Mosiwi/E1K0000_eCar_kit/README.md

# E1K0000_eCar_kit
An ESP32 car, very powerful.
