Mosiwi/E1K0000_eCar_kit/docs/source/Overview/Overview.md

# Overview    
----------
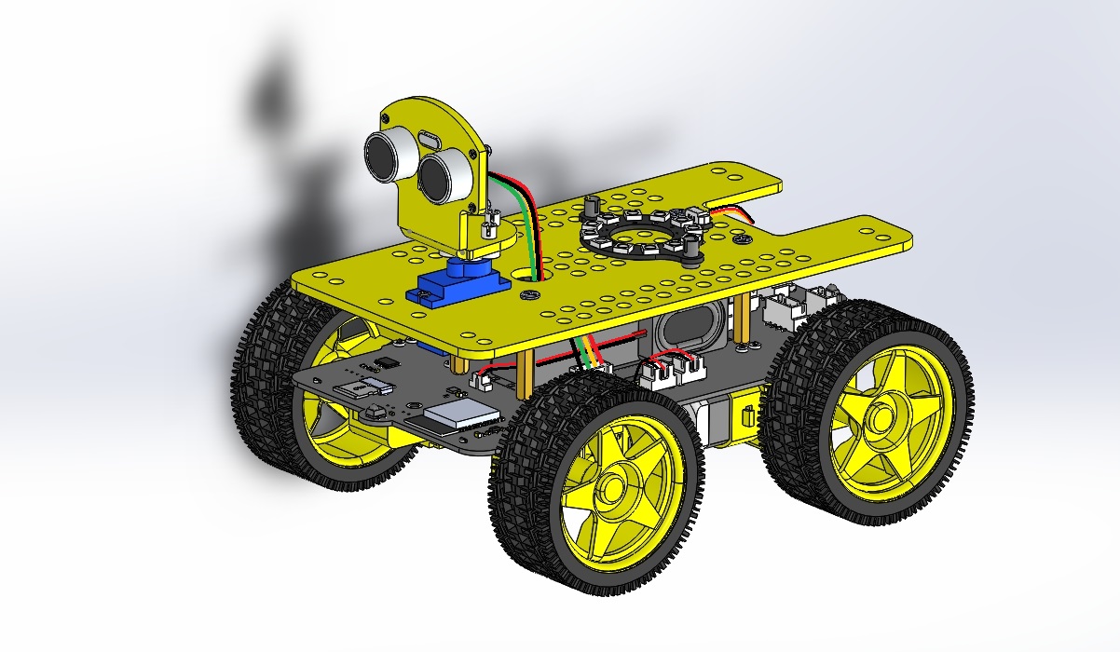
[picture p1: docs/source/_static/overview/img/0img.jpg]
    
This kit provides rich and detailed tutorial materials, very simple installation, many functions, and many interfaces reserved for users to expand by themselves, which is very suitable for DIY or electronics enthusiasts to learn and use.             

**Functional description:**      
• Web_App(Wifi) and infrared remote control.          
• 4 Motor drive (With LED car lights).           
• Speakers, MP3 players play songs (I2S).            
• SD card for storing songs, etc.          
• Touch music alarm.             
• Full color RGB LED.    
• Ultrasonic distance measurement.     
• Servo control ultrasonic module, etc.    
• Compatible with LEGO extensions.     
• IO ports are reserved to expand other functions.           
• With USB port charging function (5V).     
• With power display.         
• Repeatable programming and burning.           

## Functional diagram and specification  
---------------------------------------
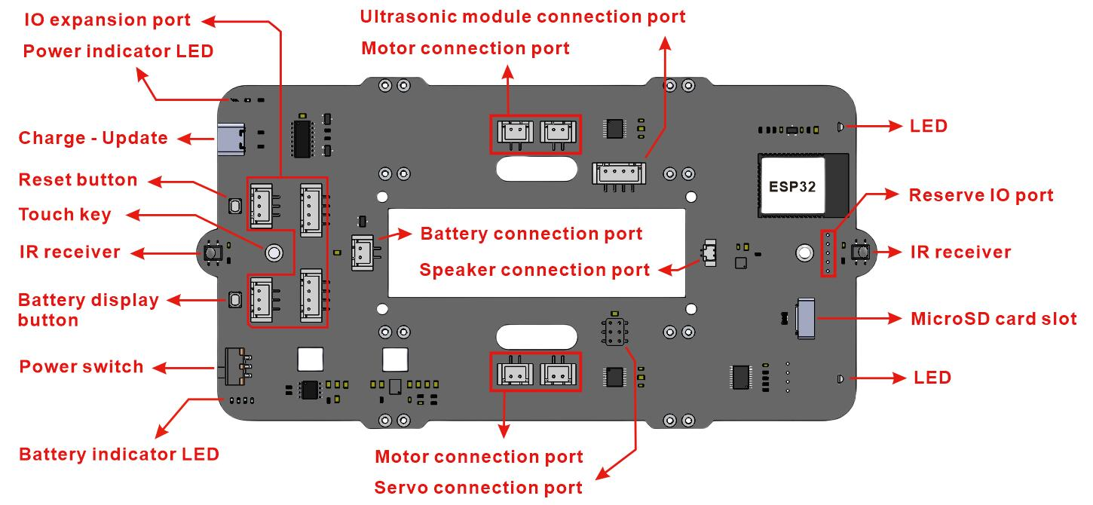
[picture p2: docs/source/_static/overview/img/22img.jpg]
      
    
• Main control chip: ESP32-WROOM-32E      
• System operating voltage: 3.3V        
• Operating voltage of IO port: 3.3V
• Maximum output power: 3.3V/2A   
• Maximum output power: 5V/2A 
• Maximum charge current: 5V/2A   
• Power of speaker: 8Ω/2W      
• Motor speed: 245rpm/6V     

## Recommended battery specification      
------------------------------------
• Model: 18650 lithium battery (Button top)    
• Capacity: >2000mAh    
• Maximum charging voltage: 4.2V    
• Nominal voltage: 3.7V   
• End-off voltage: 2.75V    
• Minimum charging current: >2A     
• Minimum discharge current: >4A   
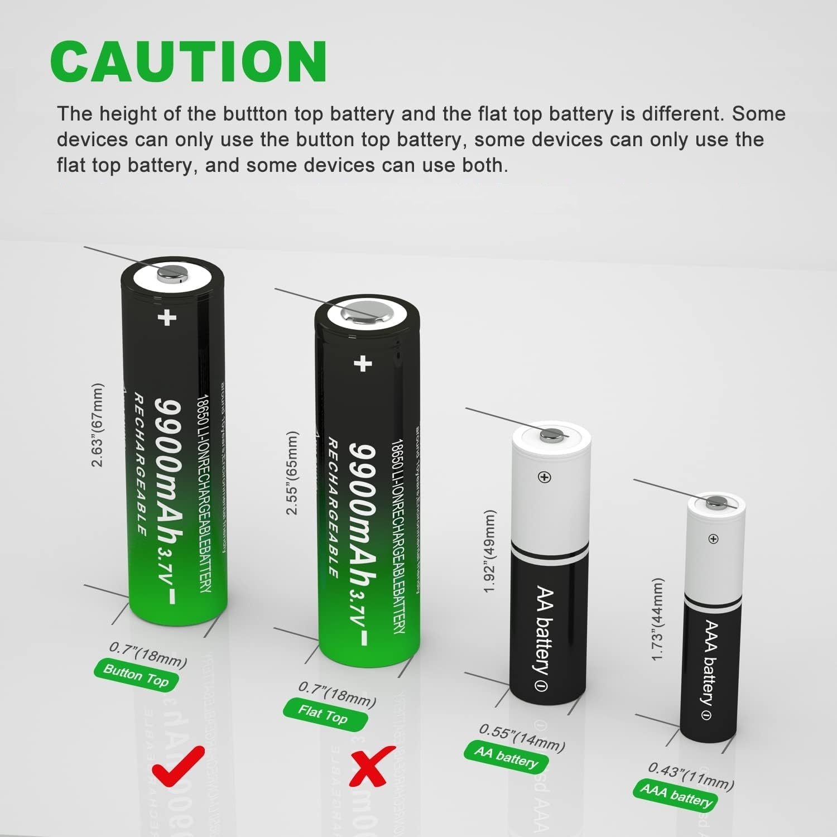
[picture p3: docs/source/_static/overview/img/21img.jpg]
      
     
```{tip}
It's easy to buy on amazon, ebay, or AliExpress.            
```

## Detailed list                
----------------
| eCar drive board | <a href="https://docs.mosiwi.com/en/latest/outsourcing/O1M0000_ultrasonic_module/O1M0000_ultrasonic_module.html" target="_blank">Ultrasonic module</a> | <a href="https://docs.mosiwi.com/en/latest/outsourcing/sg90_servo/sg90_servo.html" target="_blank">Servo</a> | 
| :--: | :--: | :--: |
| 1PCS | 1PCS | 1PCS | 
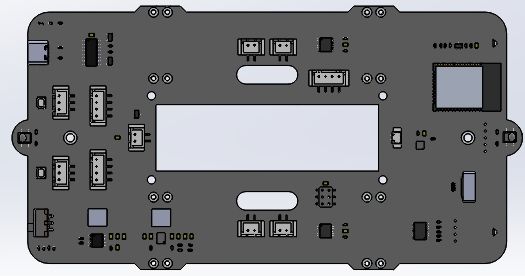
[picture p4: docs/source/_static/overview/img/1img.jpg]
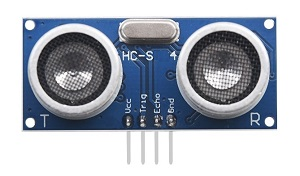
[picture p5: docs/source/_static/overview/img/2img.jpg]
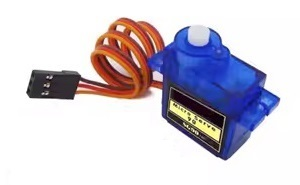
[picture p6: docs/source/_static/overview/img/3img.jpg]
|  |  |  |  
| <a href="https://docs.mosiwi.com/en/latest/outsourcing/nec_ir_remote_control/nec_ir_remote_control.html" target="_blank">IR remote control</a> | RGB LED | Speaker | 
| 1PCS | 1PCS | 1PCS | 
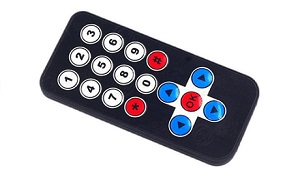
[picture p7: docs/source/_static/overview/img/4img.jpg]
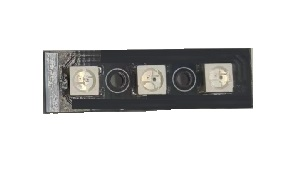
[picture p8: docs/source/_static/overview/img/5img.jpg]
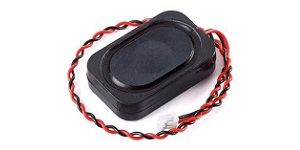
[picture p9: docs/source/_static/overview/img/6img.jpg]
|  |  |  | 
| Acrylic board | Ultrasonic module fixing parts | TT Motor | 
| 1PCS | 1PCS | 4PCS | 
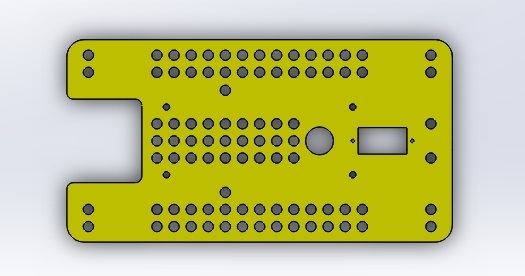
[picture p10: docs/source/_static/overview/img/7img.jpg]
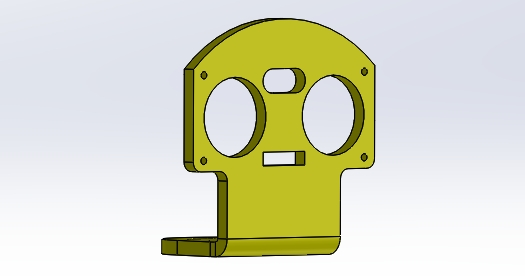
[picture p11: docs/source/_static/overview/img/8img.jpg]
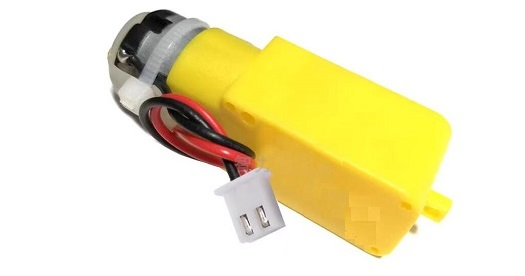
[picture p12: docs/source/_static/overview/img/9img.jpg]
|  |  |  | 
| Motor fixed parts | Wheel | Battery case | 
| 4PCS | 4PCS | 1PCS | 
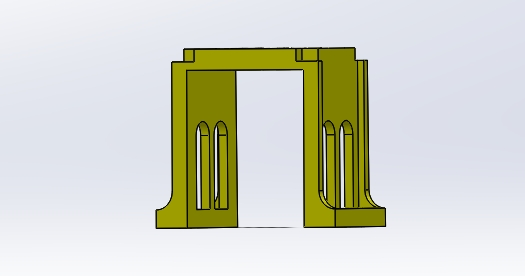
[picture p13: docs/source/_static/overview/img/10img.jpg]
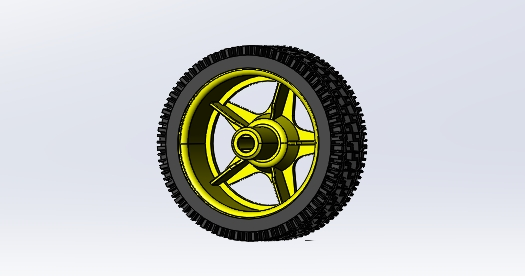
[picture p14: docs/source/_static/overview/img/11img.jpg]
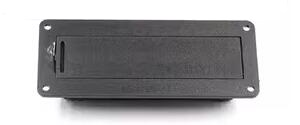
[picture p15: docs/source/_static/overview/img/12img.jpg]
|  |  |  | 
| ZH1.25 to HX2.54 cable | 4P XH2.54 cable | Servo shaft | 
| 1PCS | 1PCS | 1PCS | 
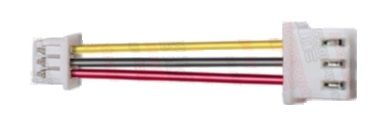
[picture p16: docs/source/_static/overview/img/13img.jpg]
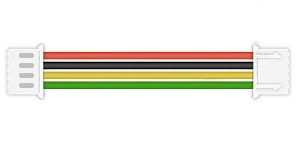
[picture p17: docs/source/_static/overview/img/14img.jpg]
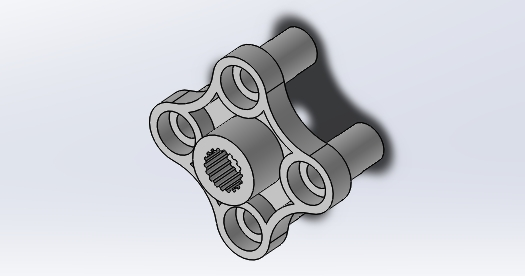
[picture p18: docs/source/_static/overview/img/24img.jpg]
|  |  |  | 
| M3x8mm round-head screw | M1.6x6mm round-head screw | M2x8mm round-head screw | 
| 8PCS | 21PCS | 2PCS | 
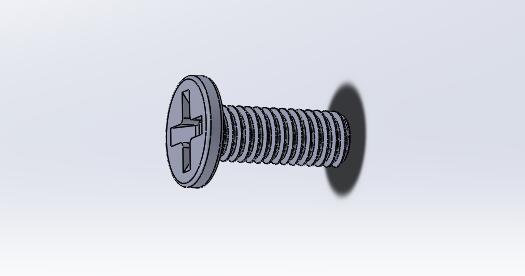
[picture p19: docs/source/_static/overview/img/17img.jpg]
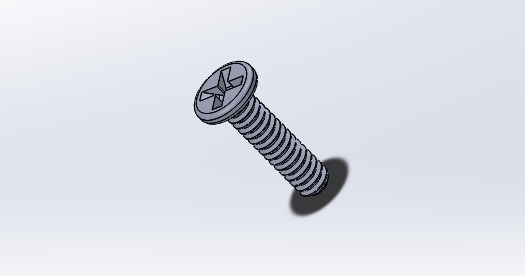
[picture p20: docs/source/_static/overview/img/25img.jpg]
|  |  |  | 
| M1.6 nuts  | M2 nuts | M3x30 dual-pass copper pillar | 
| 4PCS | 2PCS | | 
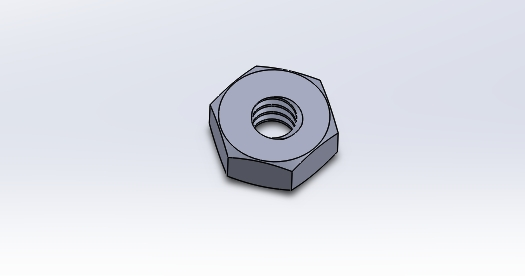
[picture p21: docs/source/_static/overview/img/16img.jpg]
|  |  | |  
| M1.6 nuts  | Latch | M3x30 dual-pass copper pillar | 
| | 2PCS | 4PCS | 
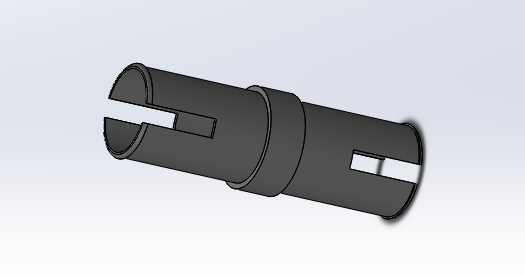
[picture p22: docs/source/_static/overview/img/27img.jpg]
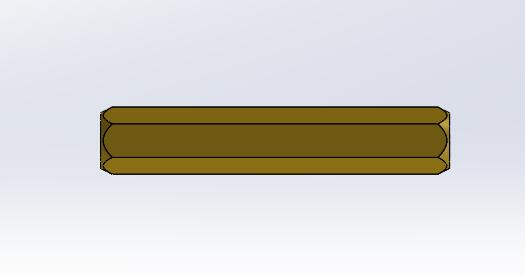
[picture p23: docs/source/_static/overview/img/23img.jpg]
| |  |  | 
| Type C USB cable  | Micro SD card | Phillips Screwdriver | 
| 1PCS | 1PCS | 1PCS | 
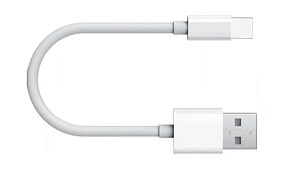
[picture p24: docs/source/_static/overview/img/18img.jpg]
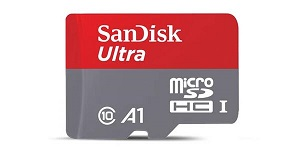
[picture p25: docs/source/_static/overview/img/19img.jpg]
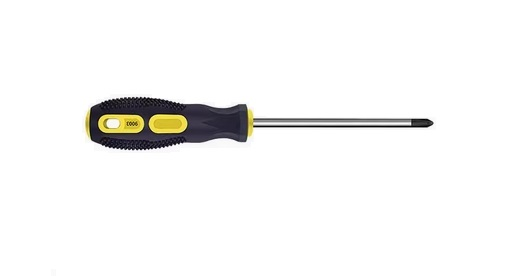
[picture p26: docs/source/_static/overview/img/20img.jpg]
|  |  |  | 

```{tip}
Click on the name in the list to get detailed specifications!   
```

## Hardware resources download     
------------------------------       
1. PCB diagram: [Click me to download!](../_static/pdf/eCar_pcb.PDF)  
2. PCB CAD file: [Click me to download!](../_static/3d/eCar.DXF)      
3. Schematic diagram: [Click me to download!](../_static/pdf/eCar_sch.PDF) 
4. ESP32-WROOM-32E datasheet: [Click me to download!](../_static/pdf/esp32-wroom-32e_esp32-wroom-32ue_datasheet_en.pdf)     
5. 3D acrylic_board: [Click me to download!](../_static/3d/Acrylic_board.STL)         
6. 3D ultrasonic module bracket: [Click me to download!](../_static/3d/Ultrasonic_module_bracket.STL)
