Mosiwi/E1K0000_eCar_kit/docs/source/index.rst

Subproject index page
=====================
Thank you for choosing Mosiwi products!

Get Technical support(E-mail): xxx@outlook.com

We also have more products and teaching resources: https://docs.mosiwi.com

If you want to download the PDF tutorial, click on "v: latest" at the bottom right corner of the sidebar.

.. note::

   Although the PDF tutorial was downloaded,
   parts of this tutorial still need to be obtained from the Internet.

.. note::

   After unpacking the product, the product has its own factory program, which can be used to assemble the product, please do not burn the program to the motherboard before assembly!  

.. toctree::
   :maxdepth: 3
   :caption: 📚 E1K0000_eCar_kit:

   1. Overview <Overview/Overview.md>
   2. Assembly <assembly/assembly.md>   
   3. Play eCar <play_ecar/play_ecar.md> 
   4. Arduino_tutorial <arduino_tutorial/arduino_tutorial.md> 

.. toctree::
   :maxdepth: 3
   :caption: 🚀 Other:

   Restore factory function <restore_factory_function/restore_factory_function.md> 
   QA <qa/qa.md>
