Mosiwi/E1K0000_eCar_kit/docs/source/_static/overview/img/26img.png

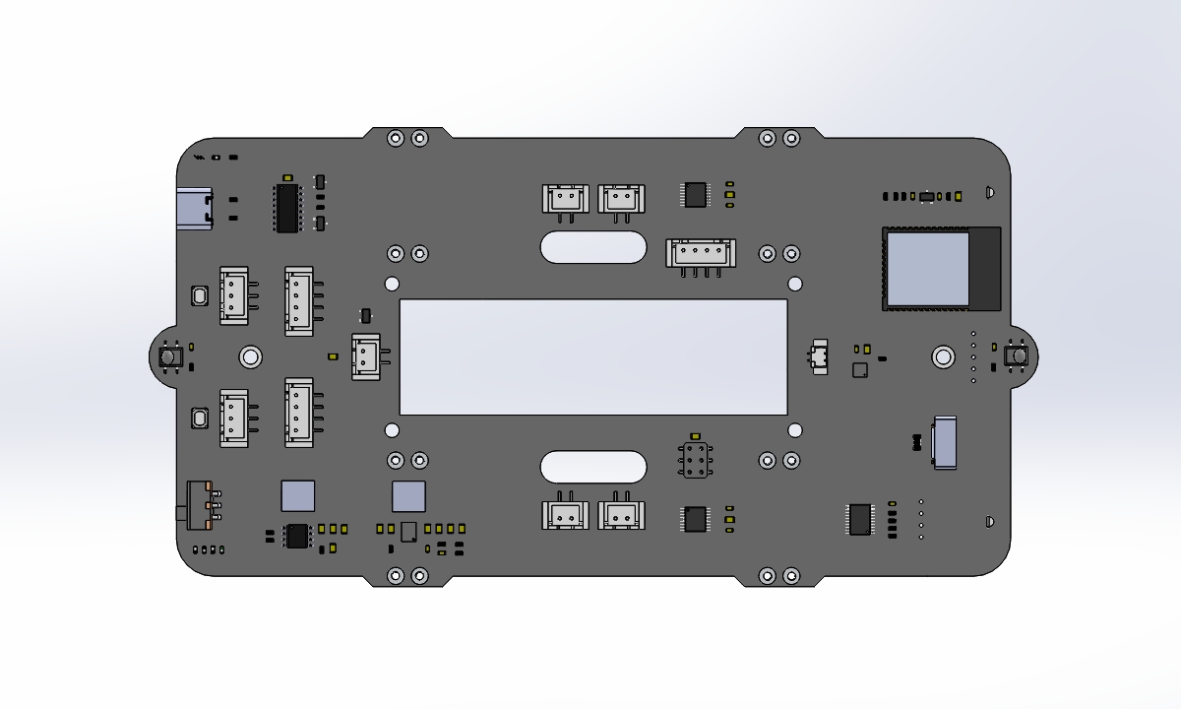
docs/source/_static/overview/img/26img.png
