Mosiwi/E1K0000_eCar_kit/docs/source/_static/3d/Acrylic_board.STL

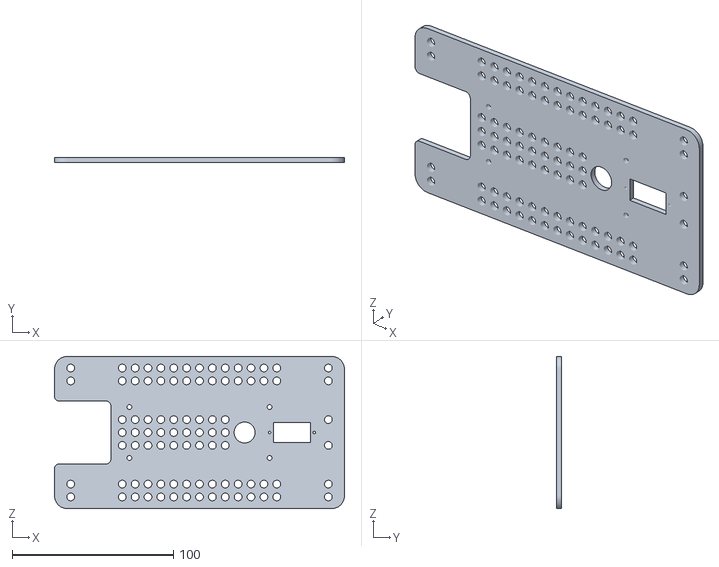
[picture p37: CAD file, 2024-06-06]
docs/source/_static/3d/Acrylic_board.STL
179.9 x 3.00 x 94.5
