Mosiwi/E1K0000_eCar_kit/docs/source/_static/3d/Ultrasonic_module_bracket.STL

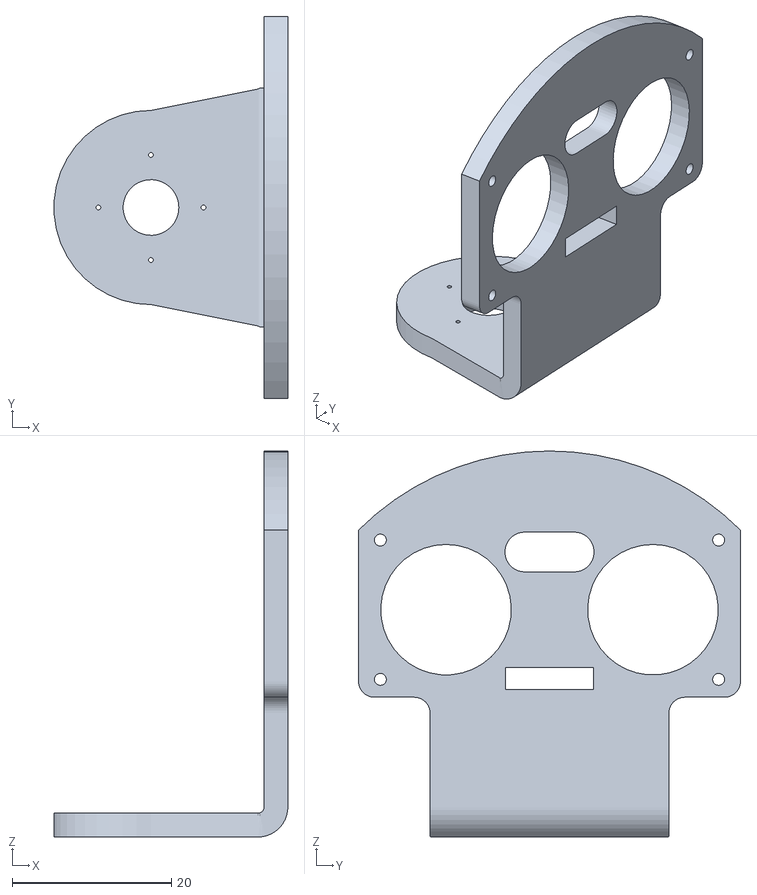
[picture p38: CAD file, 2024-06-06]
docs/source/_static/3d/Ultrasonic_module_bracket.STL
29.4 x 48.0 x 48.5
