Mosiwi/E1K0000_eCar_kit/docs/source/assembly/assembly.md

# Assembly_tutorial  
-------------------
```{note}
After unpacking the product, the product has its own factory program, which can be used to assemble the product, please do not burn the program to the motherboard before assembly!     
If you have burned other programs to the motherboard, please refer to the ["Restore Factory Functionality"](../restore_factory_function/restore_factory_function.md) section to burn factory programs!  
```             

Step1 installation and wiring of motors
---------------------------------------    
Prepare tools and components:
| PCB board | TT motors 4Pcs | Motor bracket 4Pcs | 
| :--: | :--: | :--: |
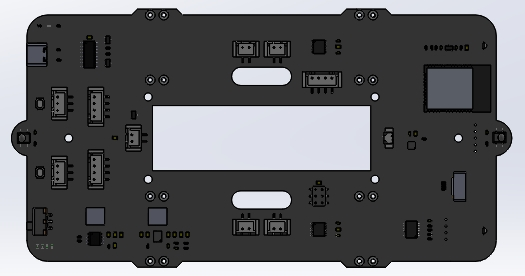
[picture p81: docs/source/_static/assembly/img/1img.jpg]
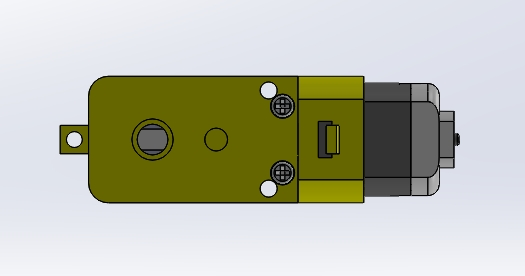
[picture p82: docs/source/_static/assembly/img/2img.jpg]
|  |  |  | 
| M1.6x6mm screw 16Pcs | Screwdriver |  |
|  |  |  |

Assembly process:     
| The four motors were fixed to the PCB with M1.6 screws. |     
|:-:|       
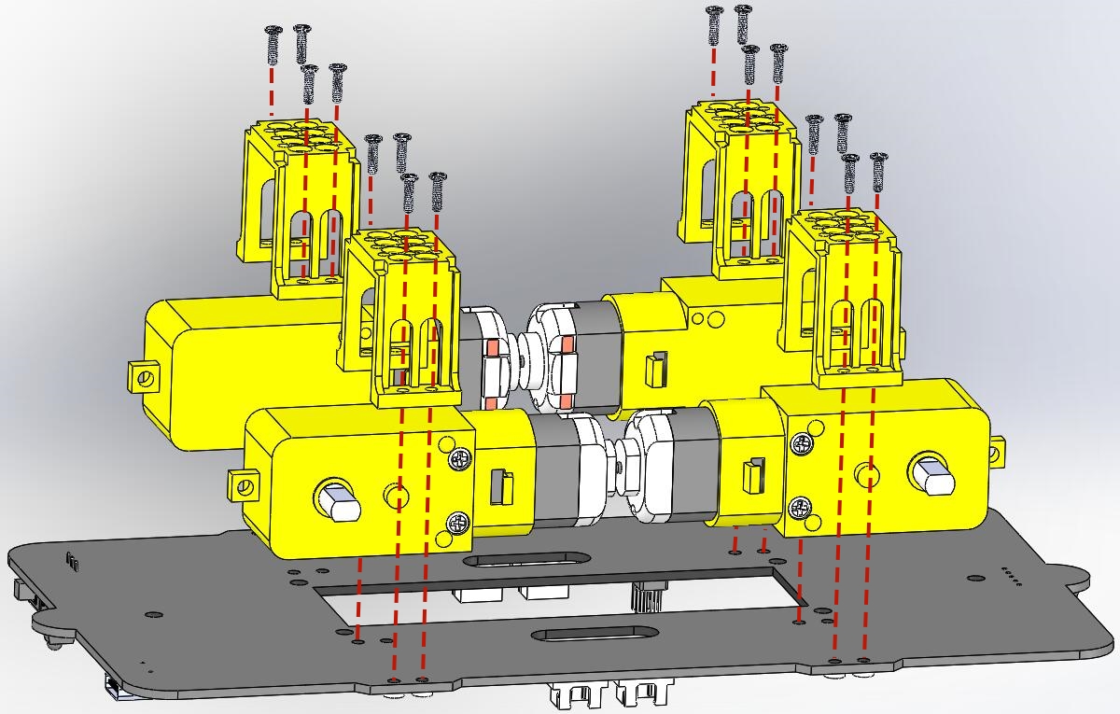
[picture p83: docs/source/_static/assembly/img/6img.jpg]
|  |    
| The image after installation. |    
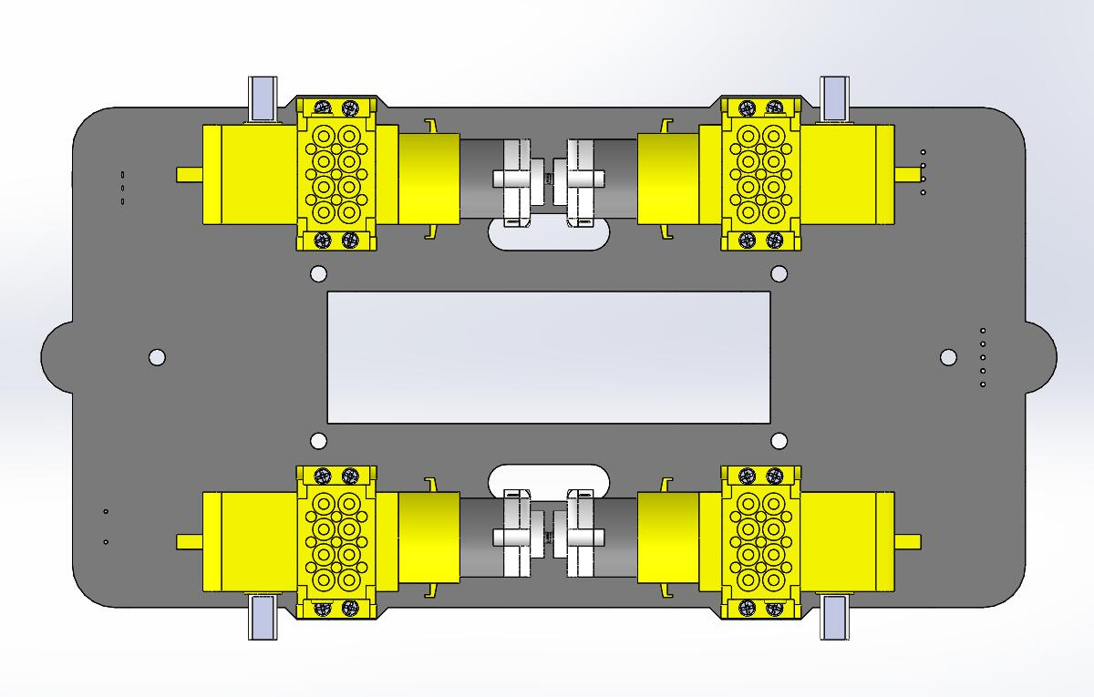
[picture p84: docs/source/_static/assembly/img/7img.jpg]
|  | 
| Please connect the motor cable according to the silk screen mark on the PCB. |
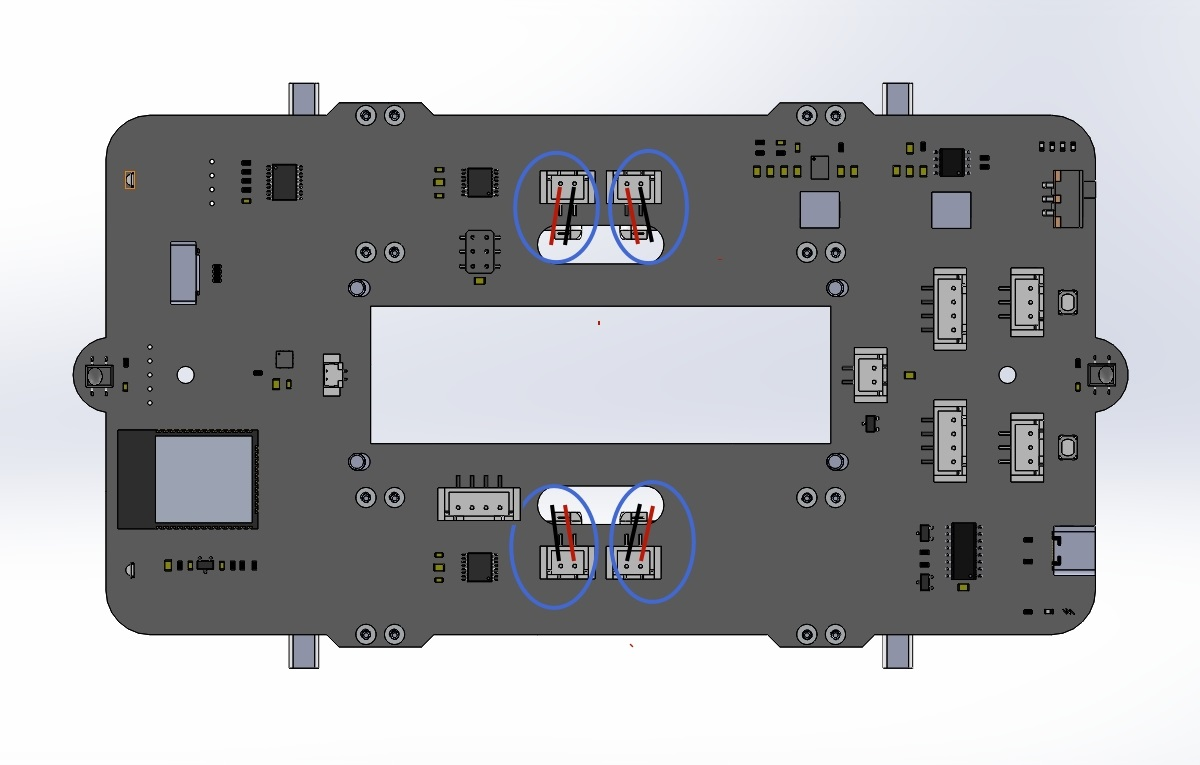
[picture p85: docs/source/_static/assembly/img/24img.jpg]
|  |   

Step2 install the wheels
------------------------ 
Prepare components:
| Step1 Install the finished part. | Wheels 4Pcs | 
| :--: | :--: |
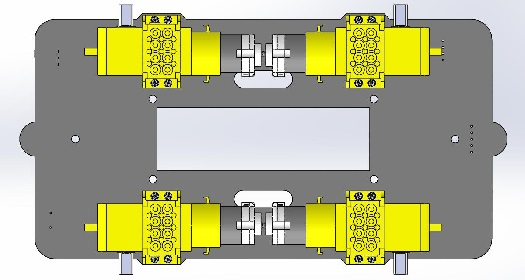
[picture p86: docs/source/_static/assembly/img/8img.jpg]
|  |  | 

Assembly process:     
| Insert the 4 wheels into the motor shaft. |     
|:-:|       
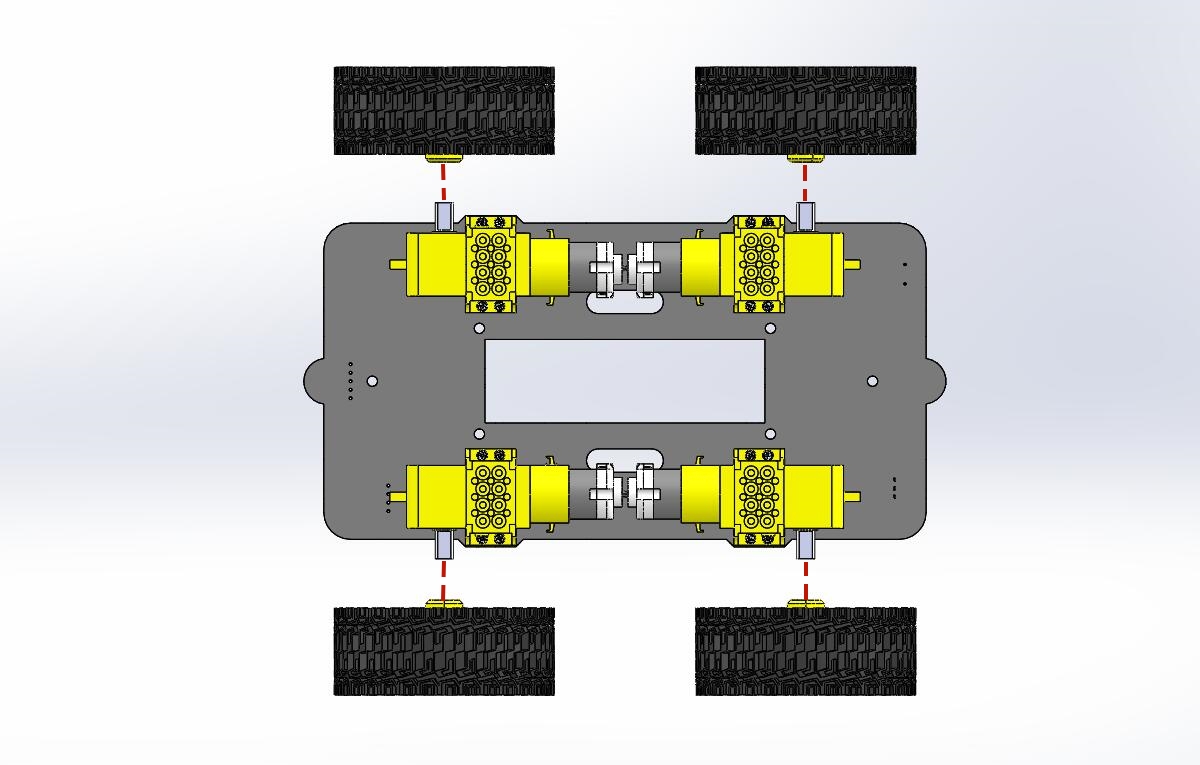
[picture p87: docs/source/_static/assembly/img/10img.jpg]
|  |    
| The image after installation. |    
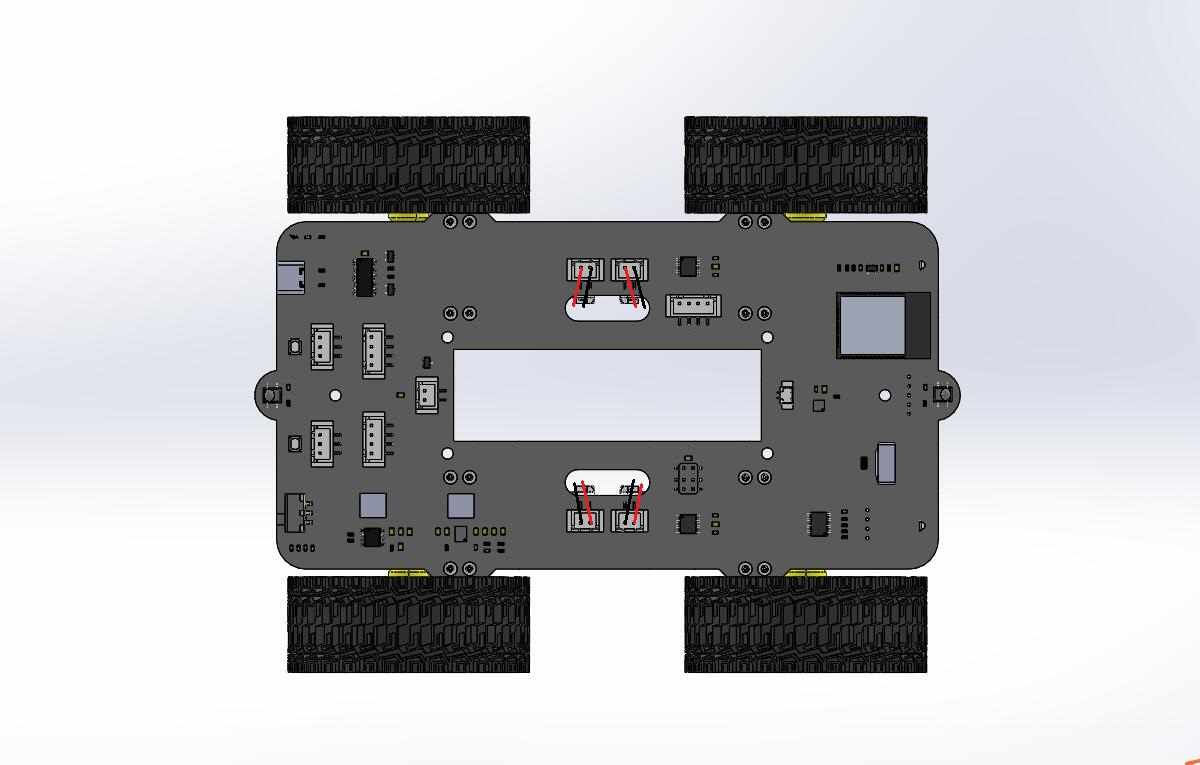
[picture p88: docs/source/_static/assembly/img/11img.jpg]
|  | 

Step3 Installation and wiring of battery box
--------------------------------------------- 
Prepare tools and components:     
| Step2 Install the finished part. | battery box | 3Mx30mm copper pillars 4Pcs | 
| :--: | :--: | :--: |
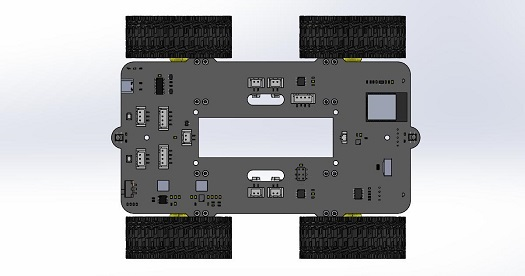
[picture p89: docs/source/_static/assembly/img/12img.jpg]
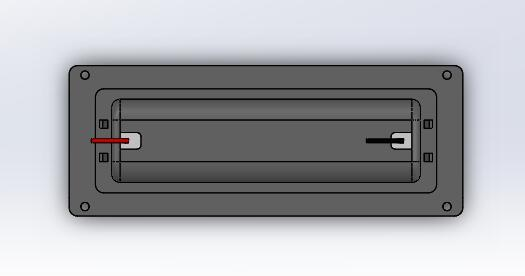
[picture p90: docs/source/_static/assembly/img/13img.jpg]
|  |  |  | 
| M3X8MM screw 4Pcs | Screwdriver | | 
|  |  |  |

Assembly process:     
| Fix the battery box to the PCB. |     
|:-:|       
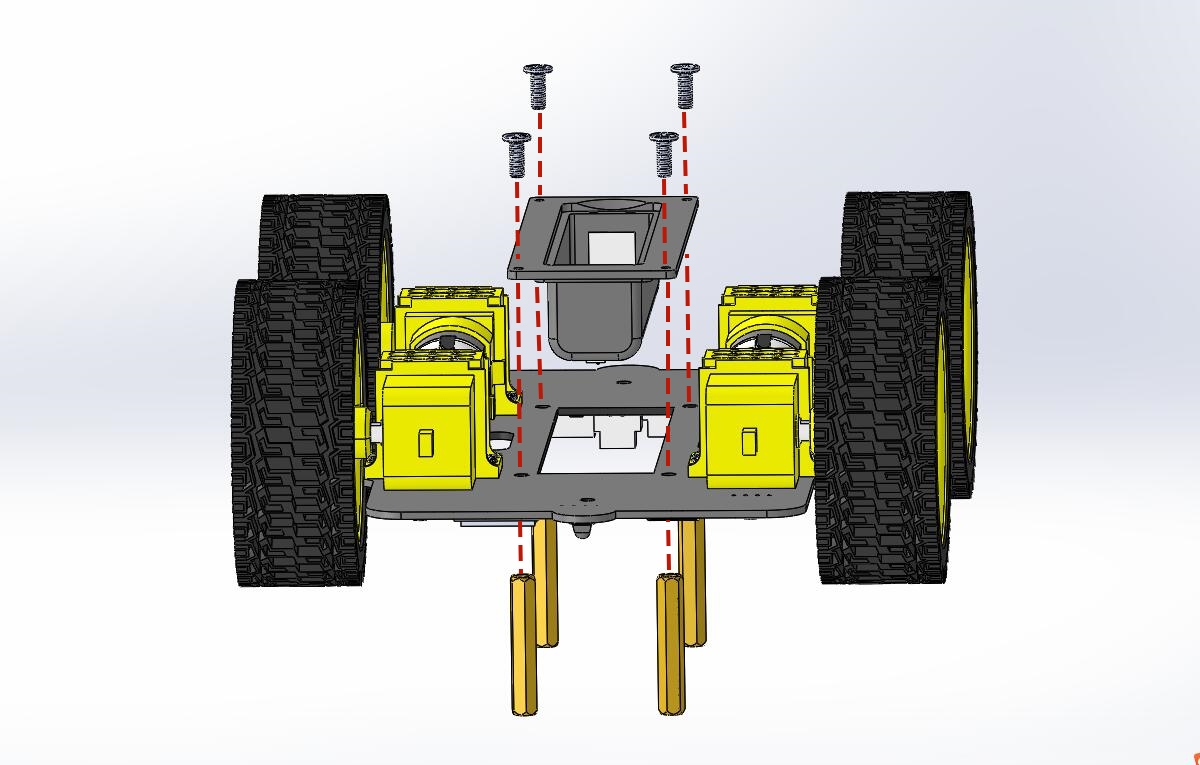
[picture p91: docs/source/_static/assembly/img/16img.jpg]
|  |    
| The image after installation. |    
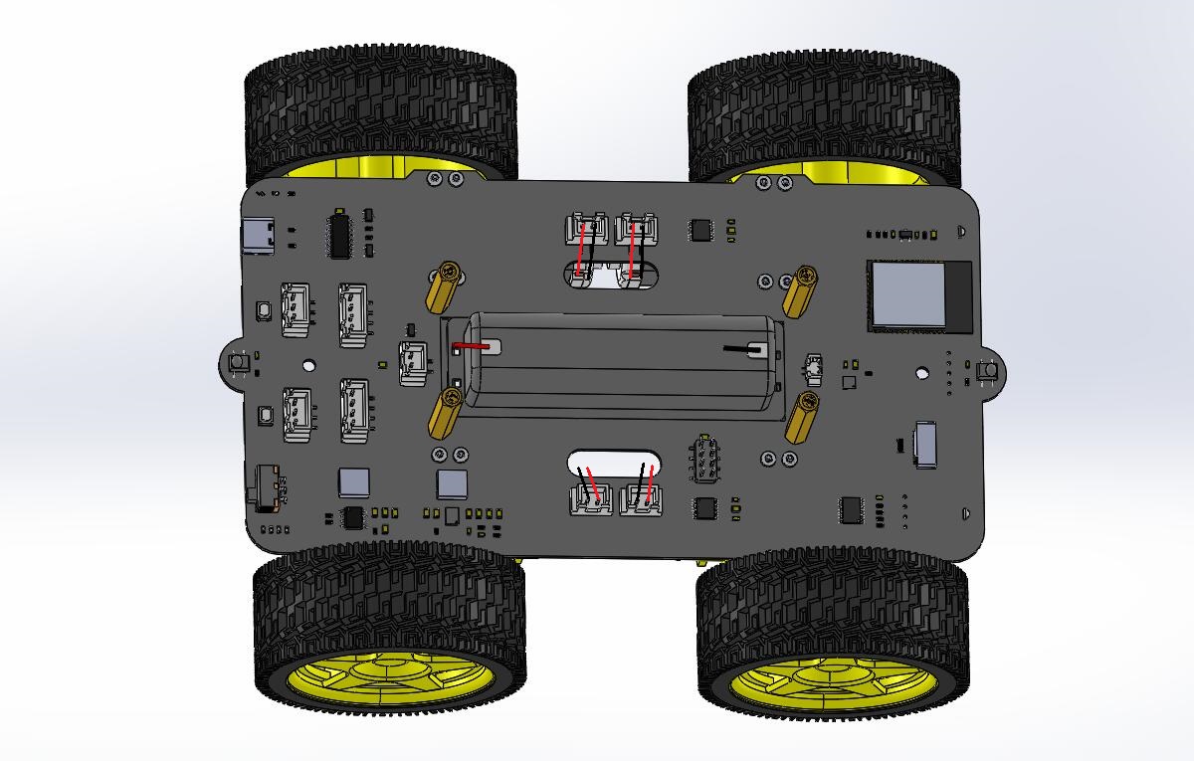
[picture p92: docs/source/_static/assembly/img/17img.jpg]
|  |   
| Battery box wiring. |    
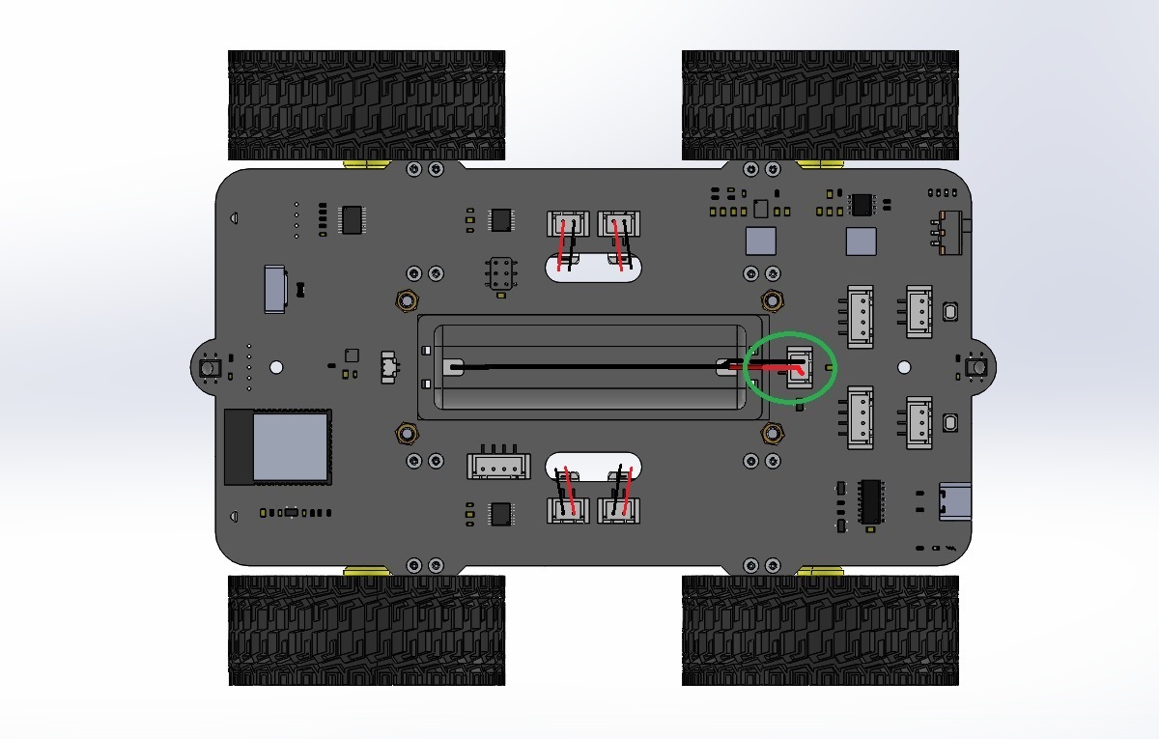
[picture p93: docs/source/_static/assembly/img/23img.jpg]
|  | 

Step4 installation and wiring of speaker
---------------------------------------- 
Prepare components:
| Step3 Install the finished part. | Speaker | 
| :--: | :--: |
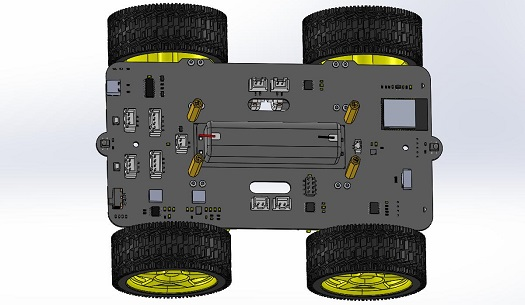
[picture p94: docs/source/_static/assembly/img/18img.jpg]
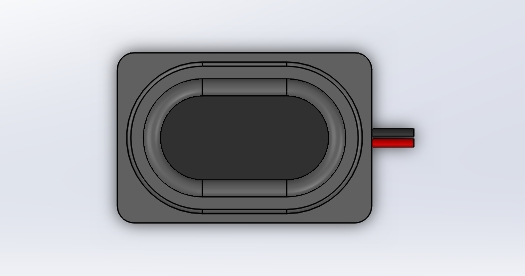
[picture p95: docs/source/_static/assembly/img/19img.jpg]
|  |  | 

Assembly process:     
| Remove the sticker on the back of the speaker and stick the speaker to the battery case. |      
|:-:|       
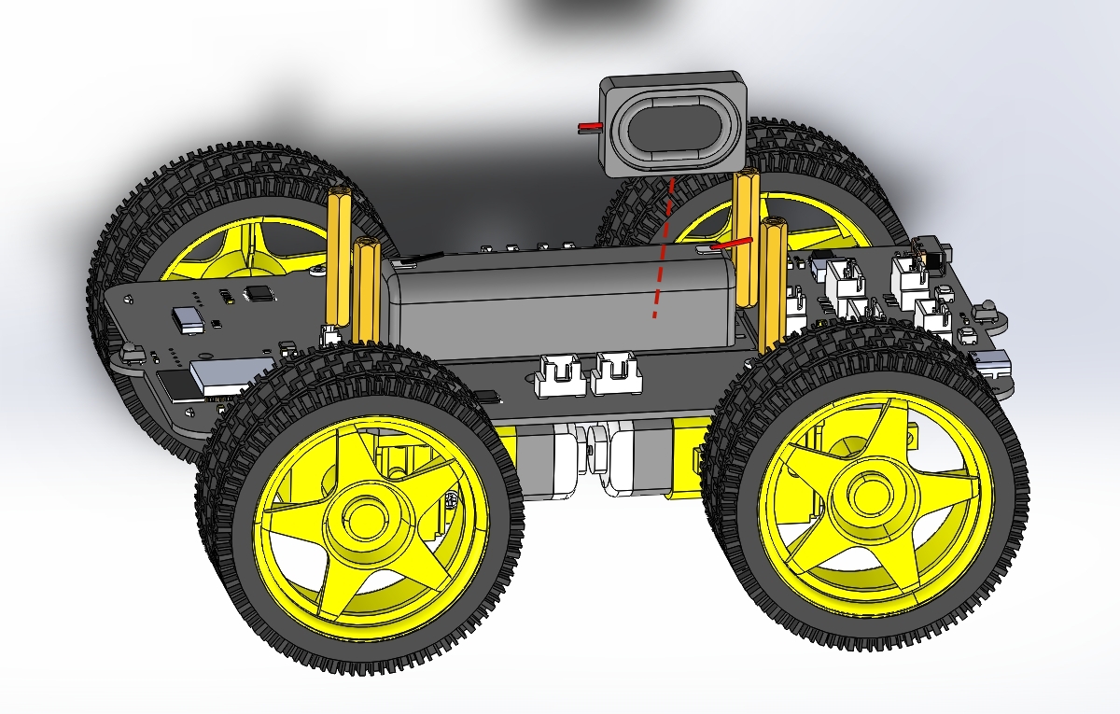
[picture p96: docs/source/_static/assembly/img/20img.jpg]
|  |     
| The image after installation. |    
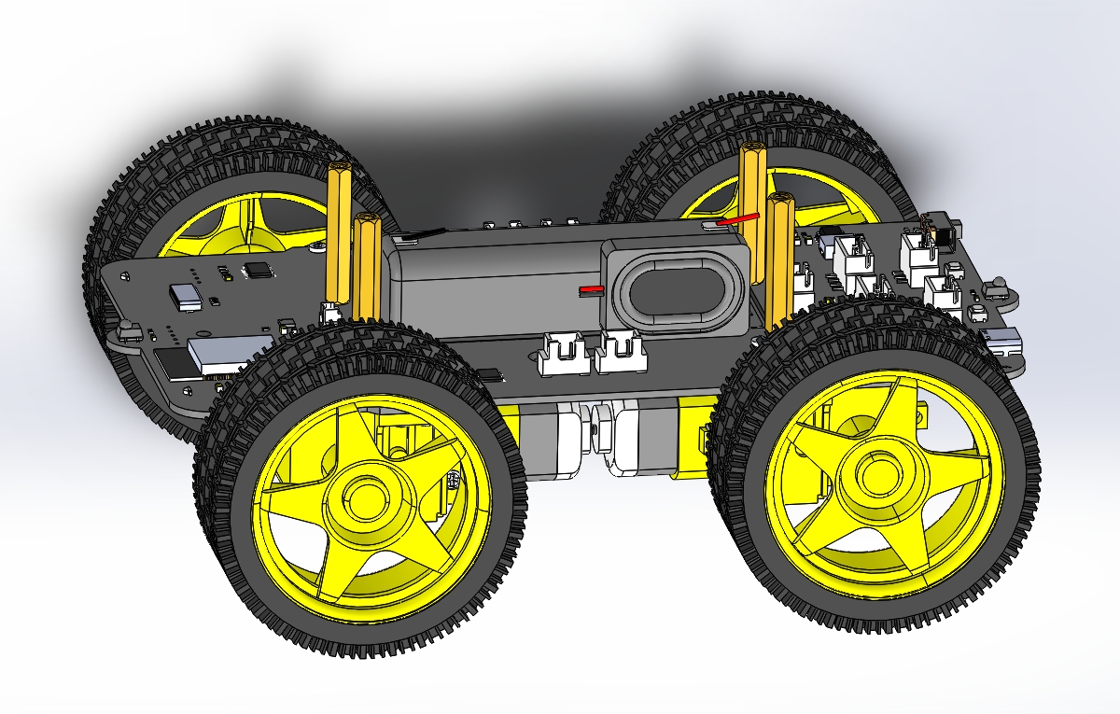
[picture p97: docs/source/_static/assembly/img/21img.jpg]
|  |     
| Speaker wiring. |
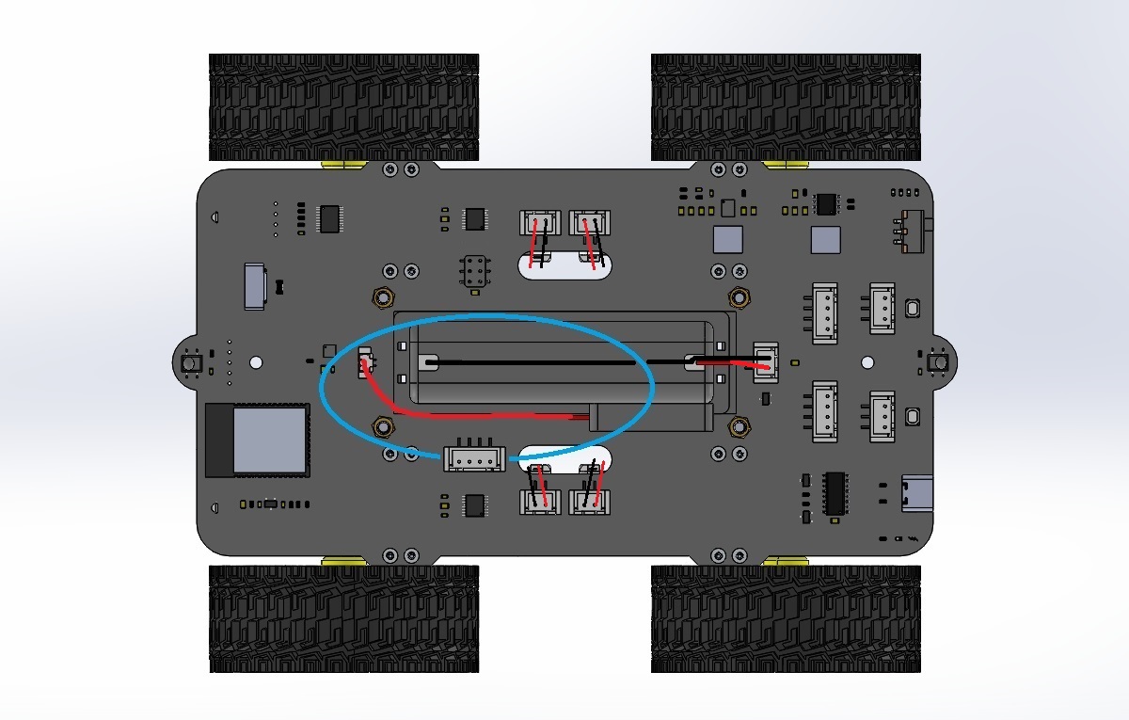
[picture p98: docs/source/_static/assembly/img/22img.jpg]
|  |  

Step5 install the servo
----------------------- 
Prepare tools and components:      
| Acrylic board | Servo | M2x8mm screw 2Pcs | 
| :--: | :--: | :--: |
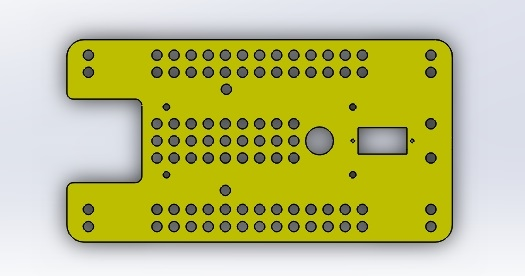
[picture p99: docs/source/_static/assembly/img/25img.jpg]
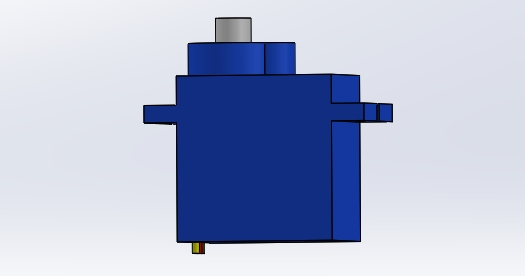
[picture p100: docs/source/_static/assembly/img/26img.jpg]
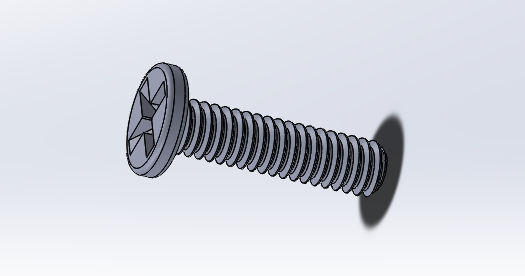
[picture p101: docs/source/_static/assembly/img/27img.jpg]
|  |  |  | 
| M2 Nut 2Pcs | Screwdriver | | 
|  |  | |

Assembly process:     
| Fix the servo to the acrylic plate. |      
|:-:|       
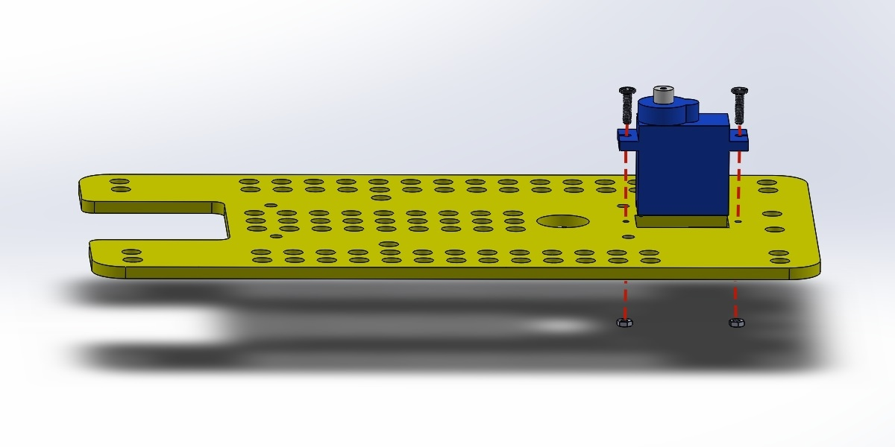
[picture p102: docs/source/_static/assembly/img/29img.jpg]
|  |     
| The image after installation. |    
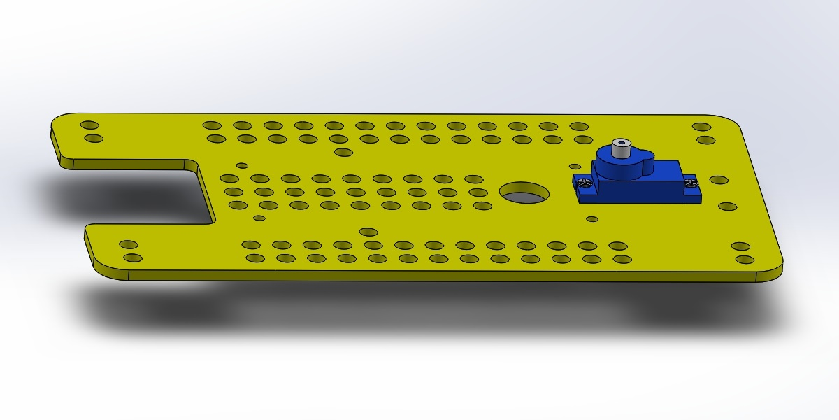
[picture p103: docs/source/_static/assembly/img/30img.jpg]
|  |     

Step6 acrylic installation and servo wiring
------------------------------------------- 
Prepare tools and components:      
| Step4 Install the finished part. | Step5 Install the finished part. | 
| :--: | :--: |
|  |  | 

Assembly process:     
| Before assembling the two parts, the wires of the servo should be connected. |      
|:-:|       
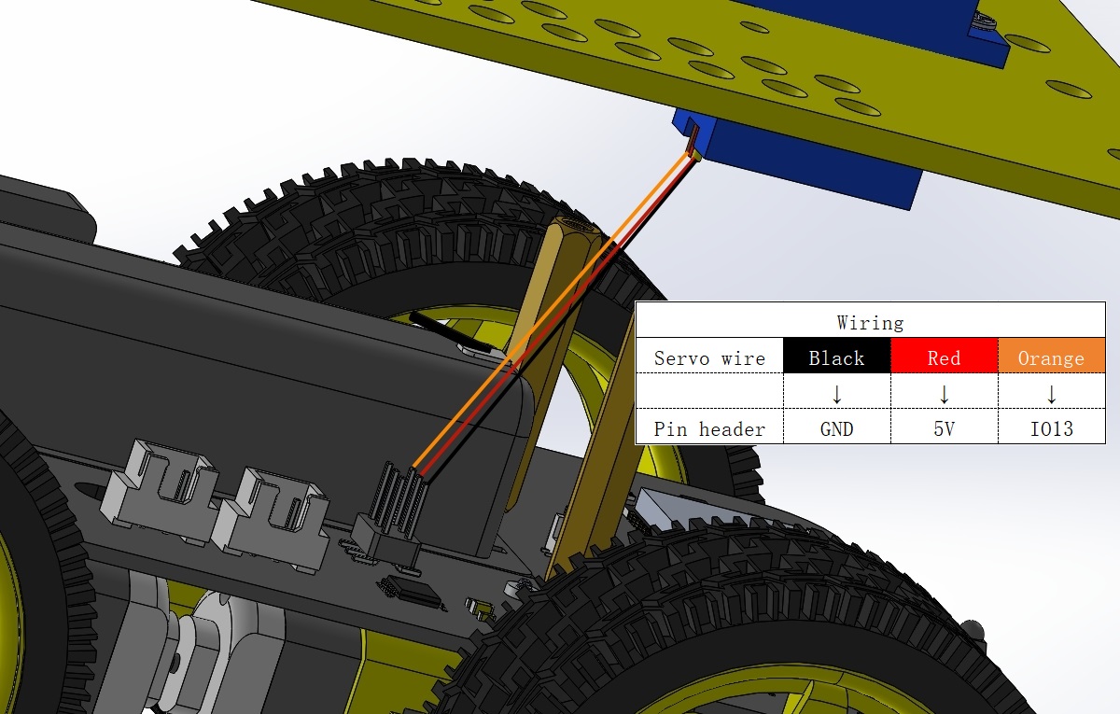
[picture p104: docs/source/_static/assembly/img/36img.jpg]
|  |    
| Assemble the two parts. |    
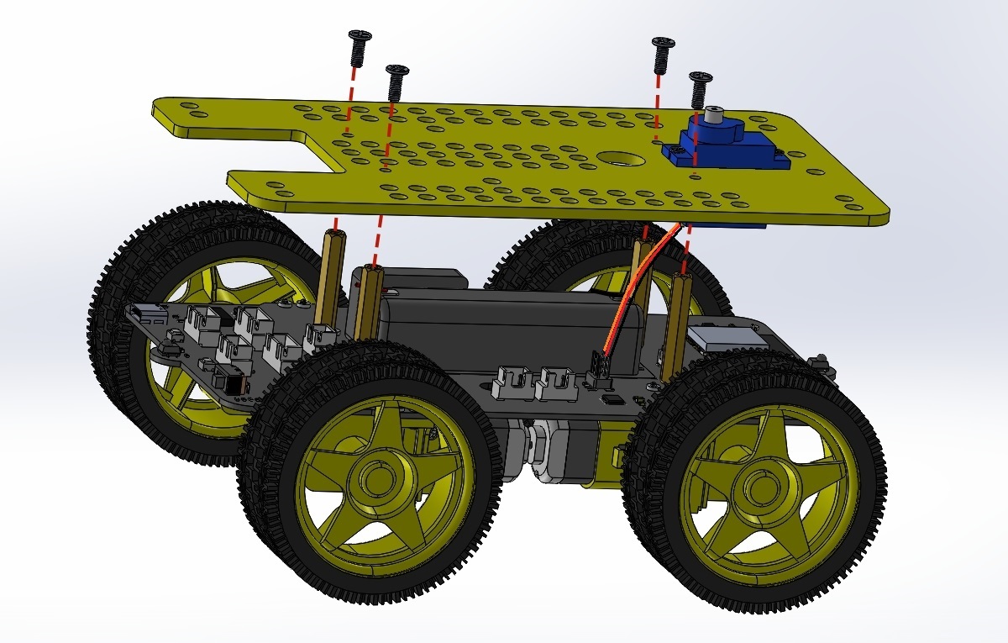
[picture p105: docs/source/_static/assembly/img/37img.jpg]
|  |    
| The image after installation. |    
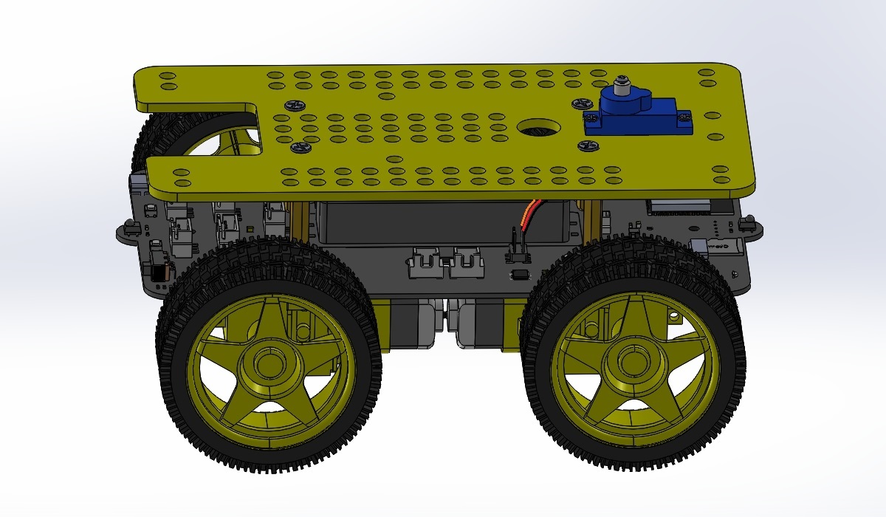
[picture p106: docs/source/_static/assembly/img/38img.jpg]
|  |  

Step7 install battery and SD card
---------------------------------   
Prepare components:   
| Step6 Install the finished part. | [18650 lithium battery](../Overview/Overview.md/#recommended-battery-specifications)(Buy it yourself) | Battery case cover | 
| :--: | :--: | :--: |
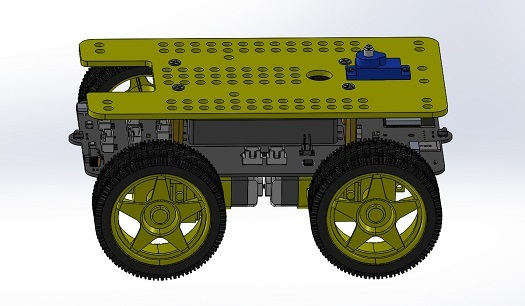
[picture p107: docs/source/_static/assembly/img/40img.jpg]
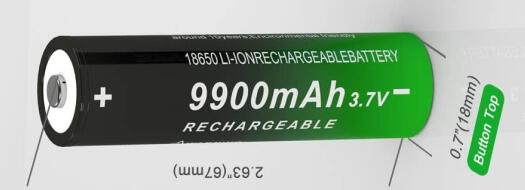
[picture p108: docs/source/_static/assembly/img/49img.jpg]
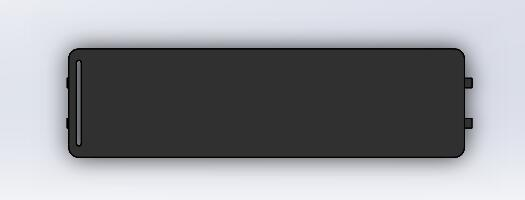
[picture p109: docs/source/_static/assembly/img/50img.jpg]
|  |  |  |  
| MicroSD card | | | 
|  | | | 

Assembly process:     
| Install battery. |      
|:-:|       
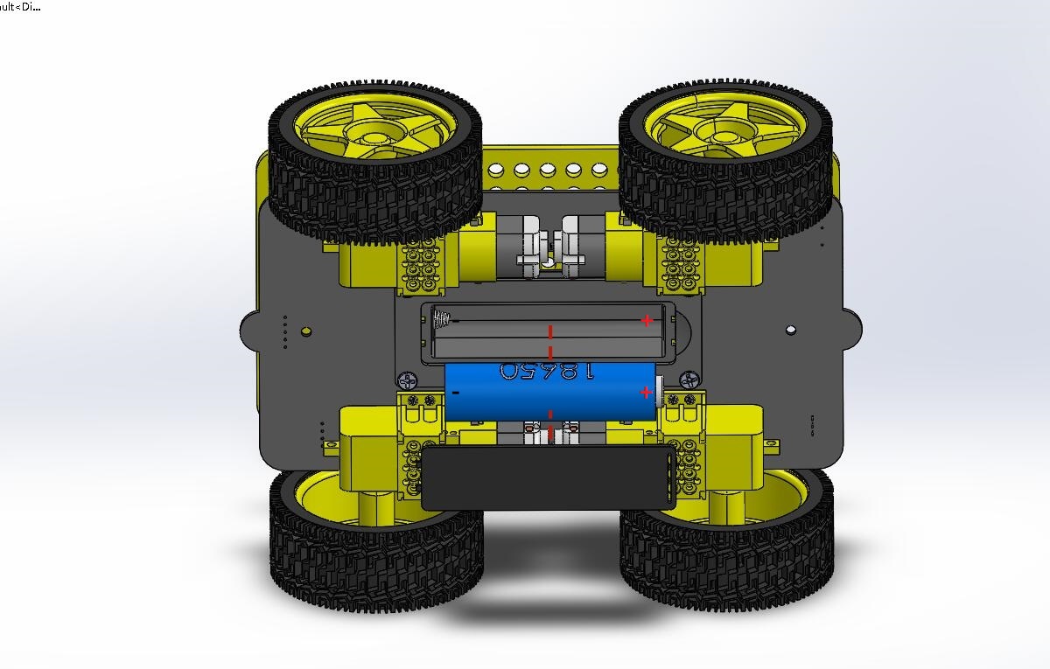
[picture p110: docs/source/_static/assembly/img/51img.jpg]
|  |    
| Install microSD card. |    
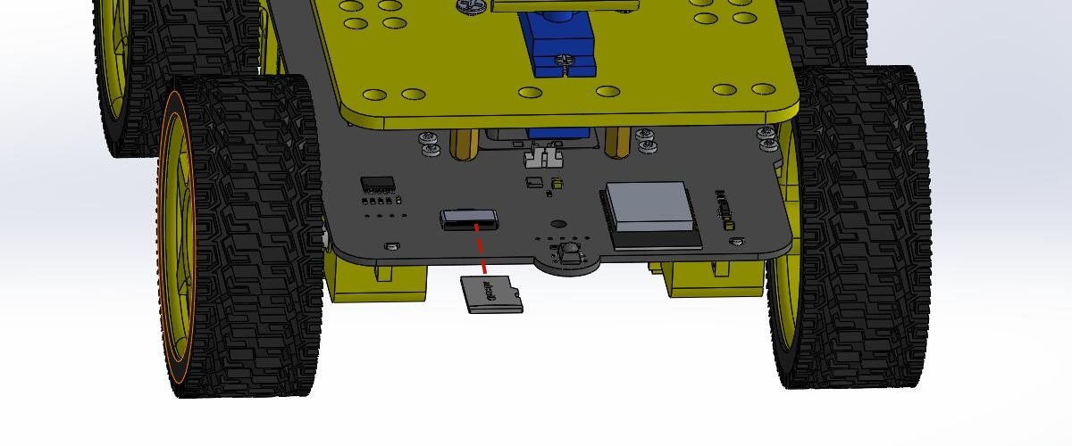
[picture p111: docs/source/_static/assembly/img/52img.jpg]
|  |    

Step8 servo angle initialization
--------------------------------      
Before installing the servo shaft, the power switch must be turned on to run the factory program and initialize the servo to 90 degrees. If the servo is at 90 degrees, it will not rotate and will not produce any sound when turned on; If the servo is not at 90 degrees, the servo will rotate and produce sound when turned on (this is a probability event).    

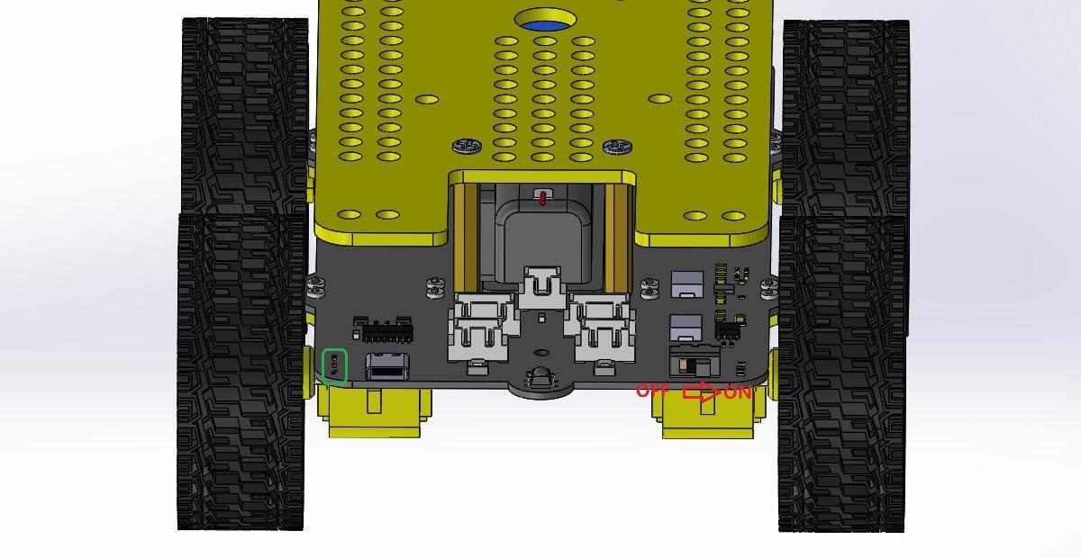
[picture p112: docs/source/_static/assembly/img/46img.jpg]
     
After turning on the power switch, the left power indicator LED will light up.          

Step9 install servo shaft
------------------------- 
Prepare tools and components:      
| Step8 Install the finished part. | Servo shaft bracket | M1.6x6mm screw 1Pcs | 
| :--: | :--: | :--: |
|  |  |  | 
| Screwdriver | | | 
|  | | |

Assembly process:     
| Fix the bracket on the servo shaft. |      
|:-:|       
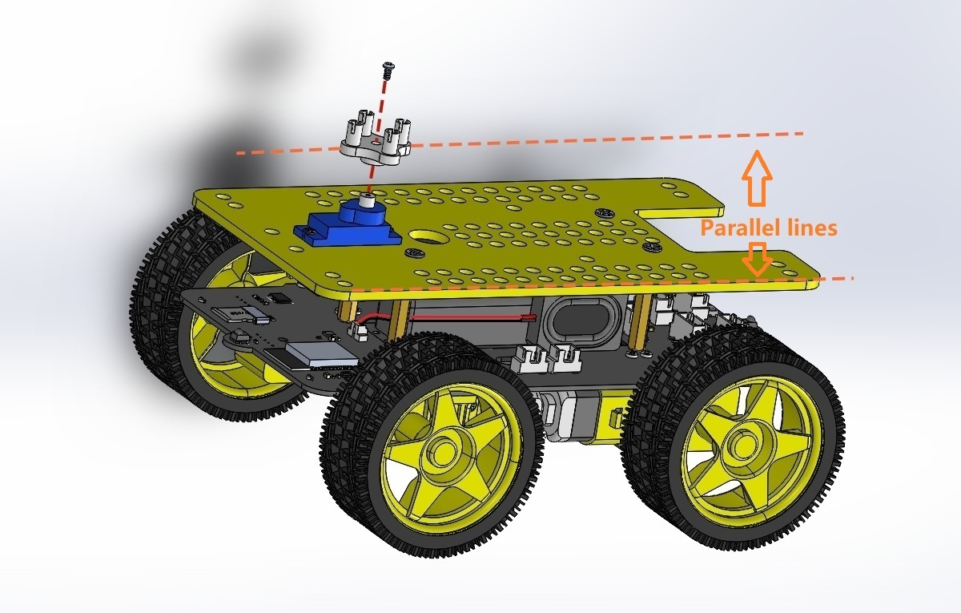
[picture p113: docs/source/_static/assembly/img/41img.jpg]
|  |     
| The image after installation. |    
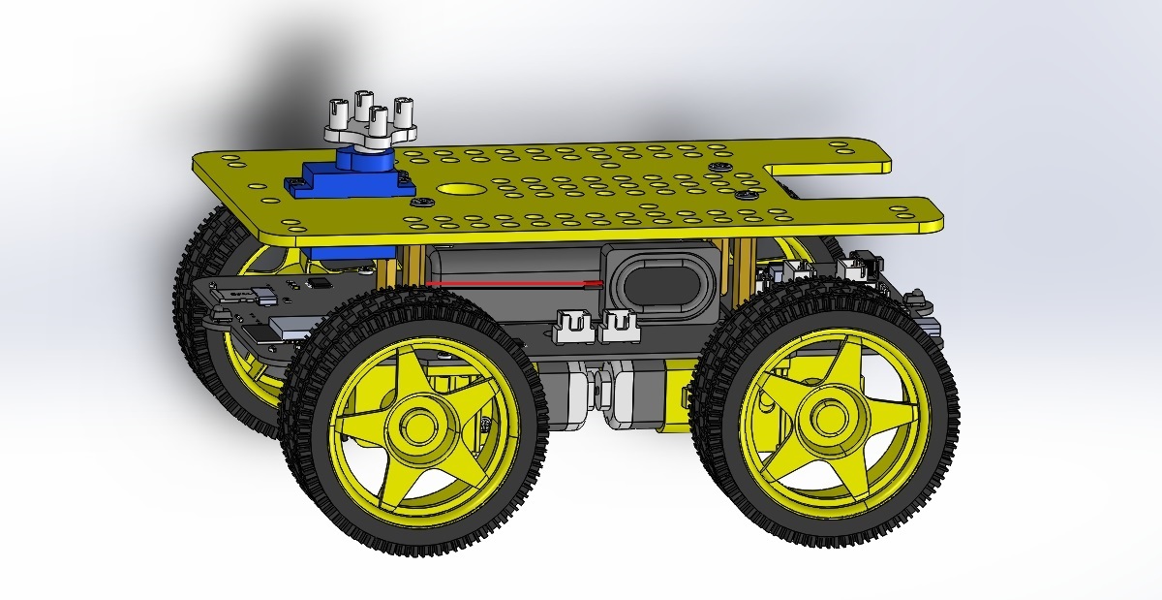
[picture p114: docs/source/_static/assembly/img/42img.jpg]
|  | 

Step10 install ultrasonic module
-------------------------------- 
Prepare tools and components:      
| Ultrasonic module | Ultrasonic module bracket | M1.6x6mm screw 4Pcs | 
| :--: | :--: | :--: |
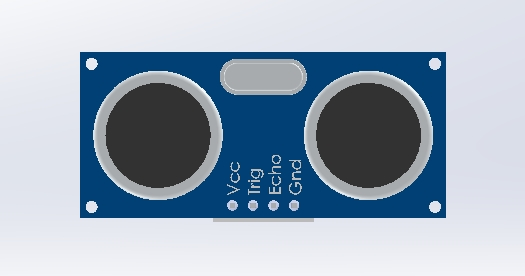
[picture p115: docs/source/_static/assembly/img/32img.jpg]
|  |  |  | 
| M1.6 Nut 4Pcs | Screwdriver | 4P connection cable | 
|  |  |  |

Assembly process:     
| Fix the ultrasonic module on the bracket. |      
|:-:|       
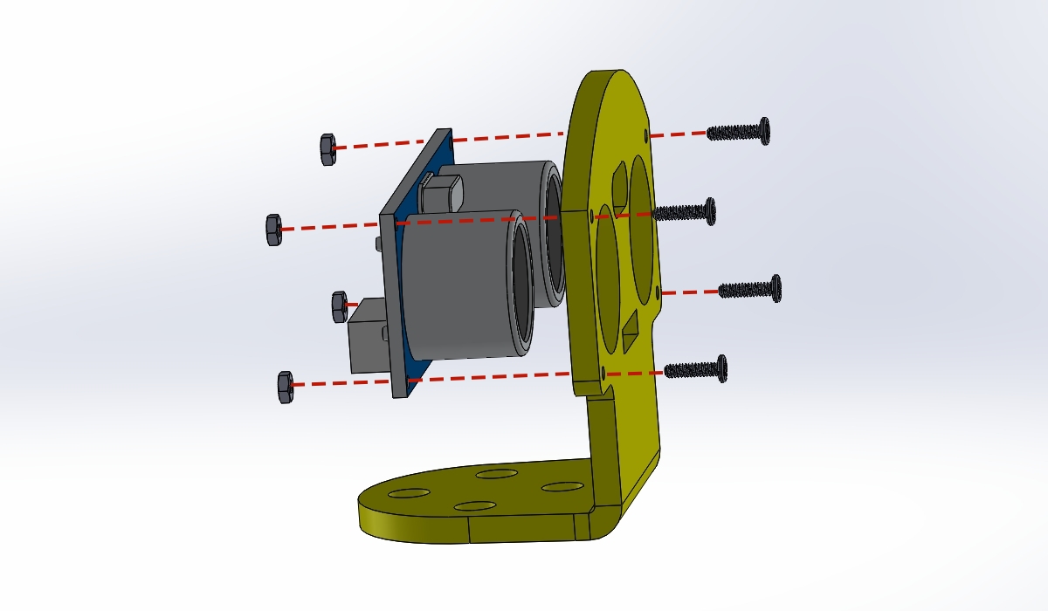
[picture p116: docs/source/_static/assembly/img/34img.jpg]
|  |     
| The image after installation. |    
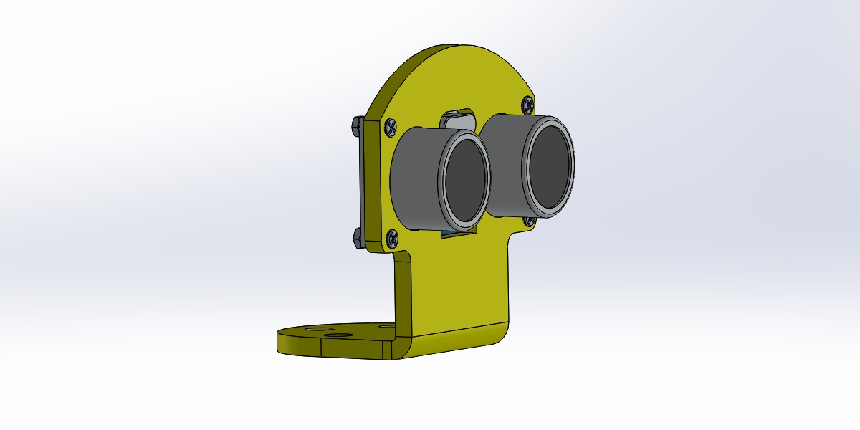
[picture p117: docs/source/_static/assembly/img/35img.jpg]
|  |   

Step11 Install the ultrasonic module bracket   
-------------------------------------------- 
Prepare tools and components:      
| Step9 Install the finished part. | Step10 Install the finished part. | 
| :--: | :--: |
|  |  | 

Assembly process:     
| Fix the ultrasonic module bracket on the servo bracket. |      
|:-:|       
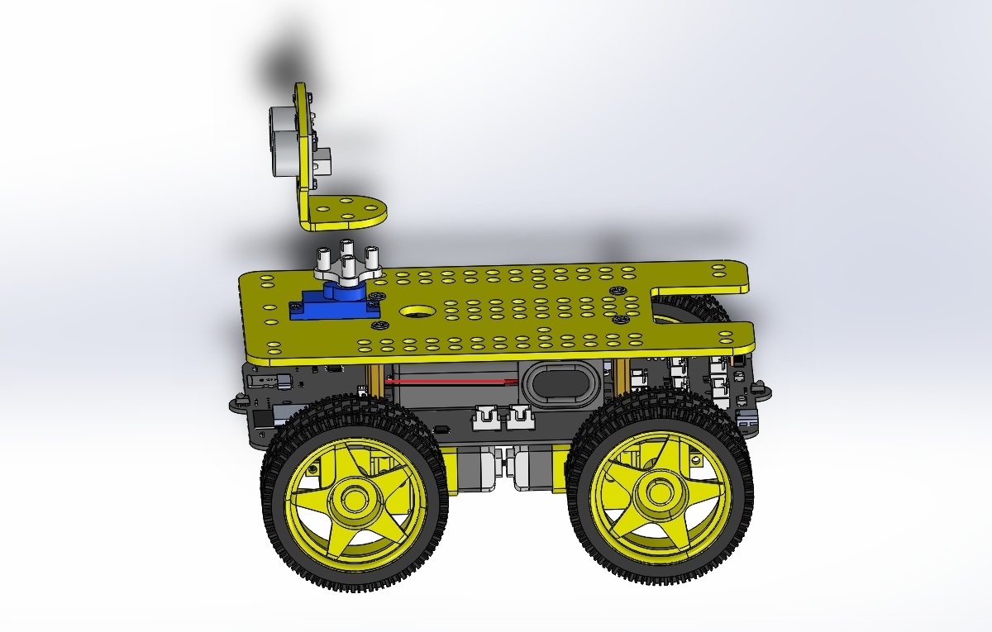
[picture p118: docs/source/_static/assembly/img/43img.jpg]
|  |     
| The image after installation. |    
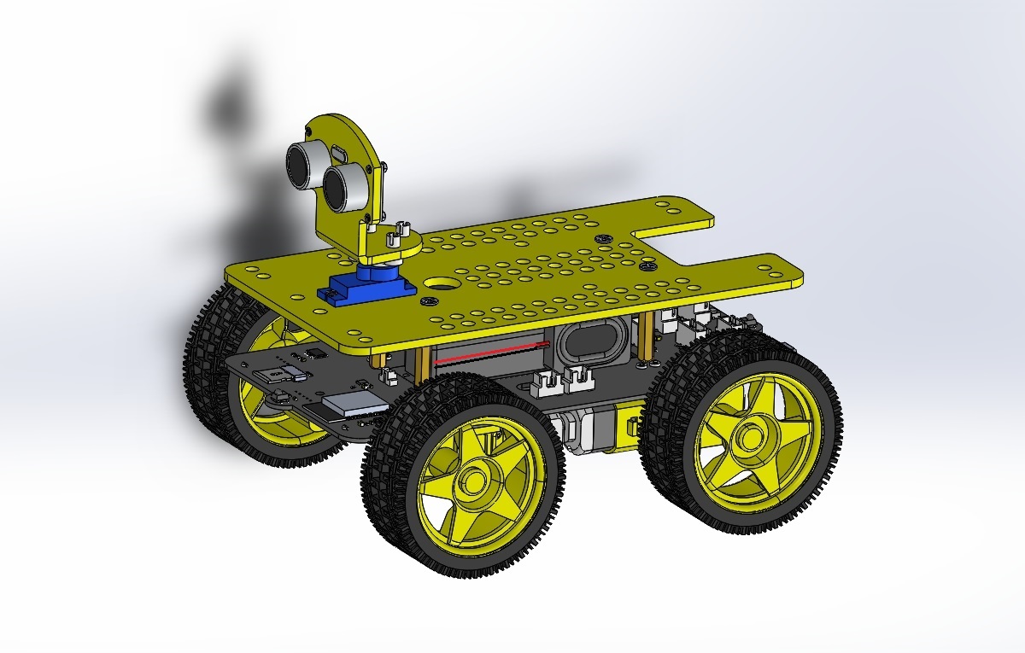
[picture p119: docs/source/_static/assembly/img/44img.jpg]
|  |   
|  Ultrasonic module wiring |    
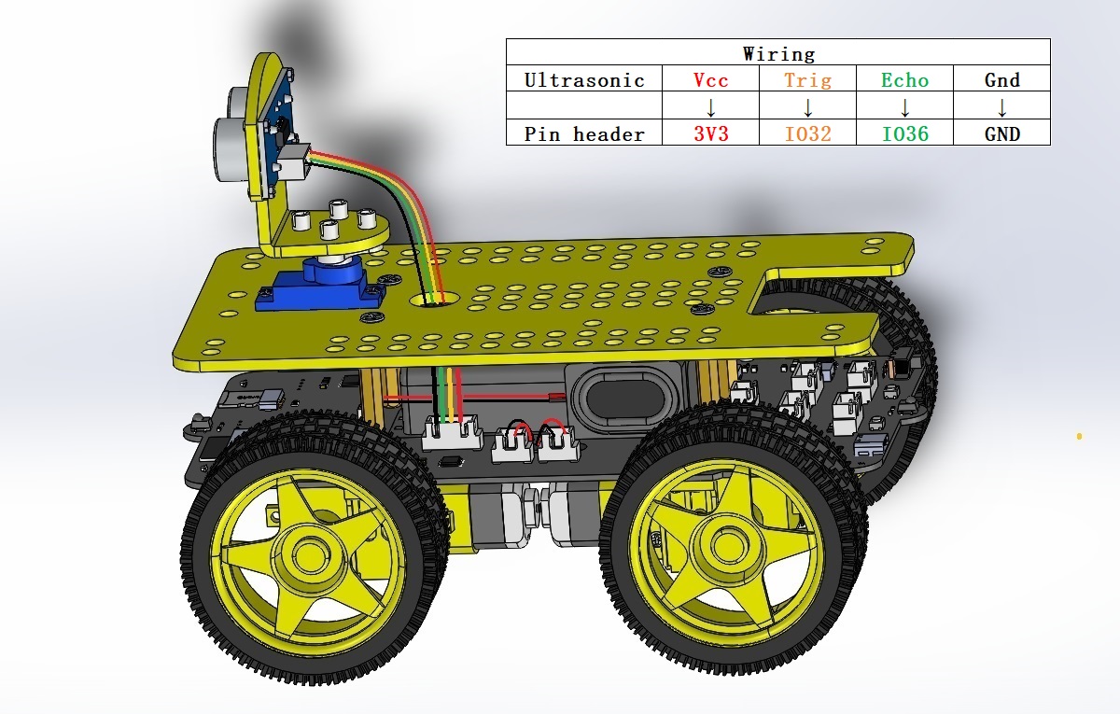
[picture p120: docs/source/_static/assembly/img/45img.jpg]
|  |    

Step12 Install the RGB LED module        
---------------------------------- 
Prepare tools and components:      
| Step11 Install the finished part. | RGB LED module | Latch 2Pcs | 
| :--: | :--: | :--: |
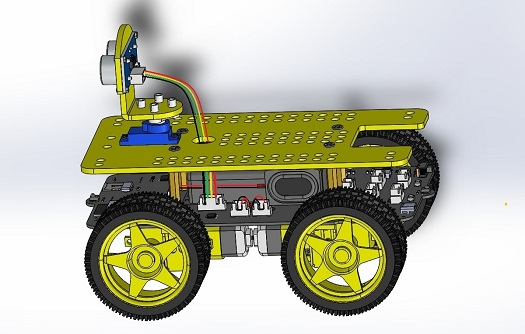
[picture p121: docs/source/_static/assembly/img/54img.jpg]
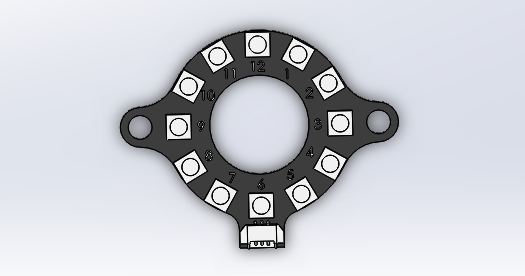
[picture p122: docs/source/_static/assembly/img/53img.jpg]
|  |  |  | 
| 3P connection cable | | | 
|  | | | 

Assembly process:     
| Fix the RGB LED module to the acrylic plate. |      
|:-:|       
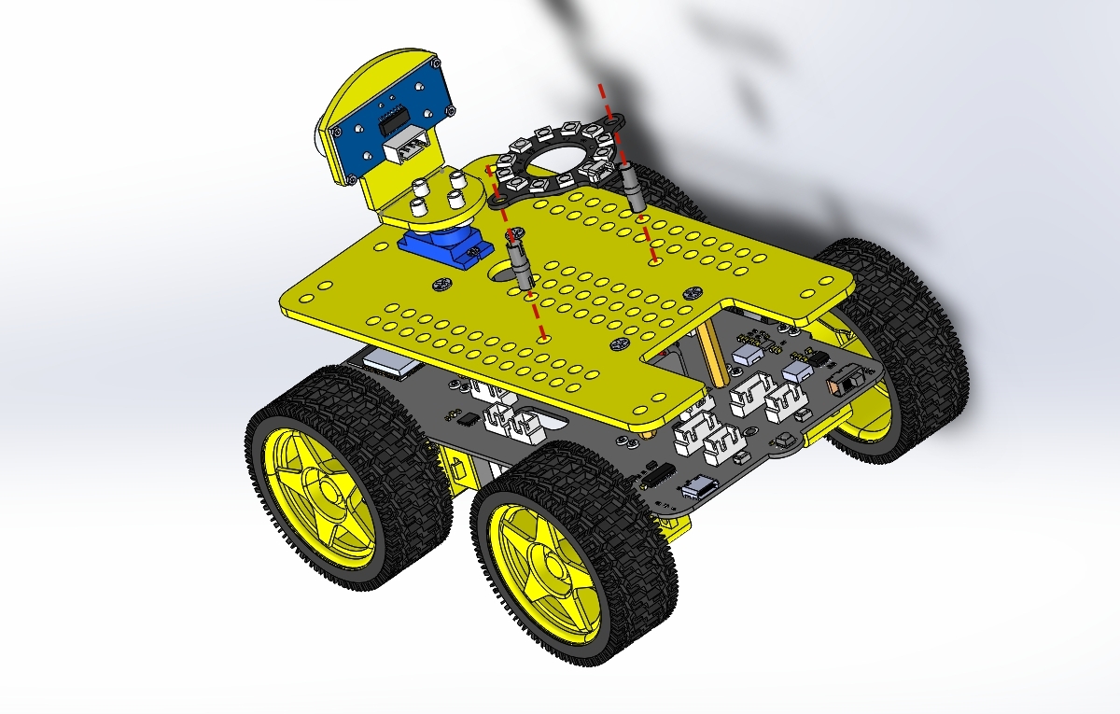
[picture p123: docs/source/_static/assembly/img/56img.jpg]
|  |     
|  RGB LED module wiring |    
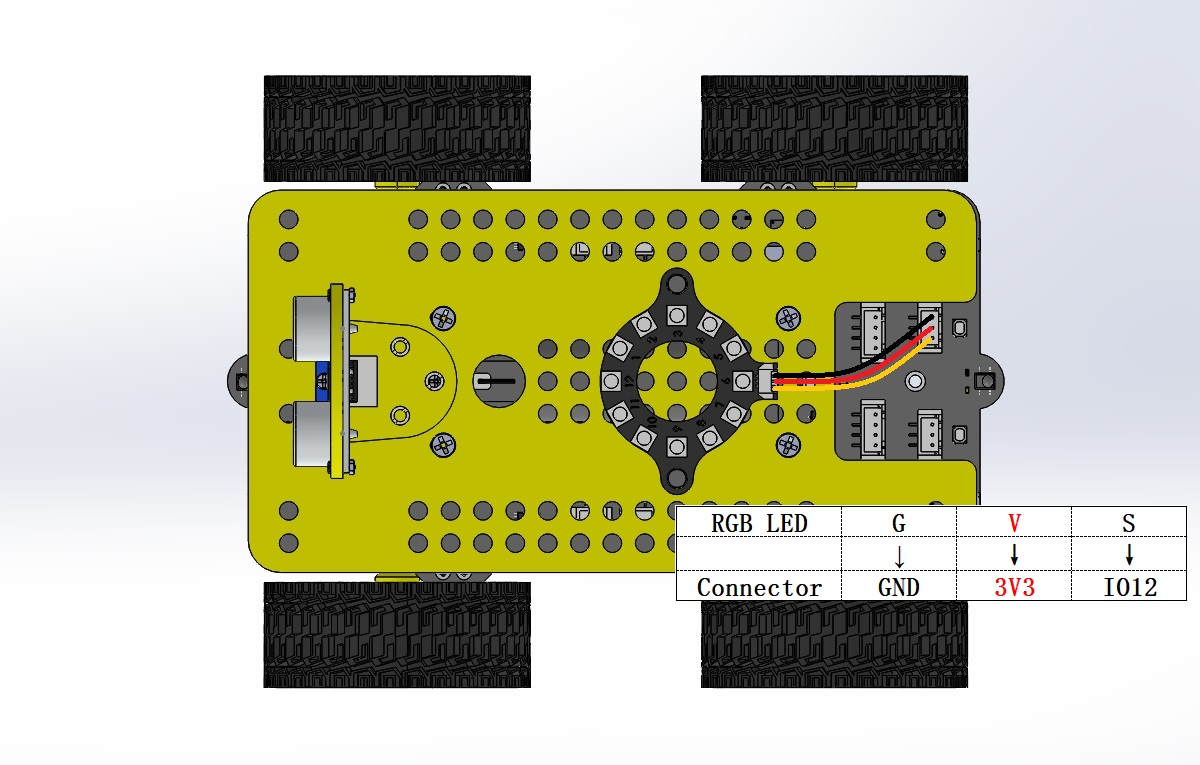
[picture p124: docs/source/_static/assembly/img/57img.jpg]
|  |   
| The image after installation. |    
|  |   

End!
