Mosiwi/E1K0000_eCar_kit/docs/source/_static/pdf/eCar_pcb.PDF

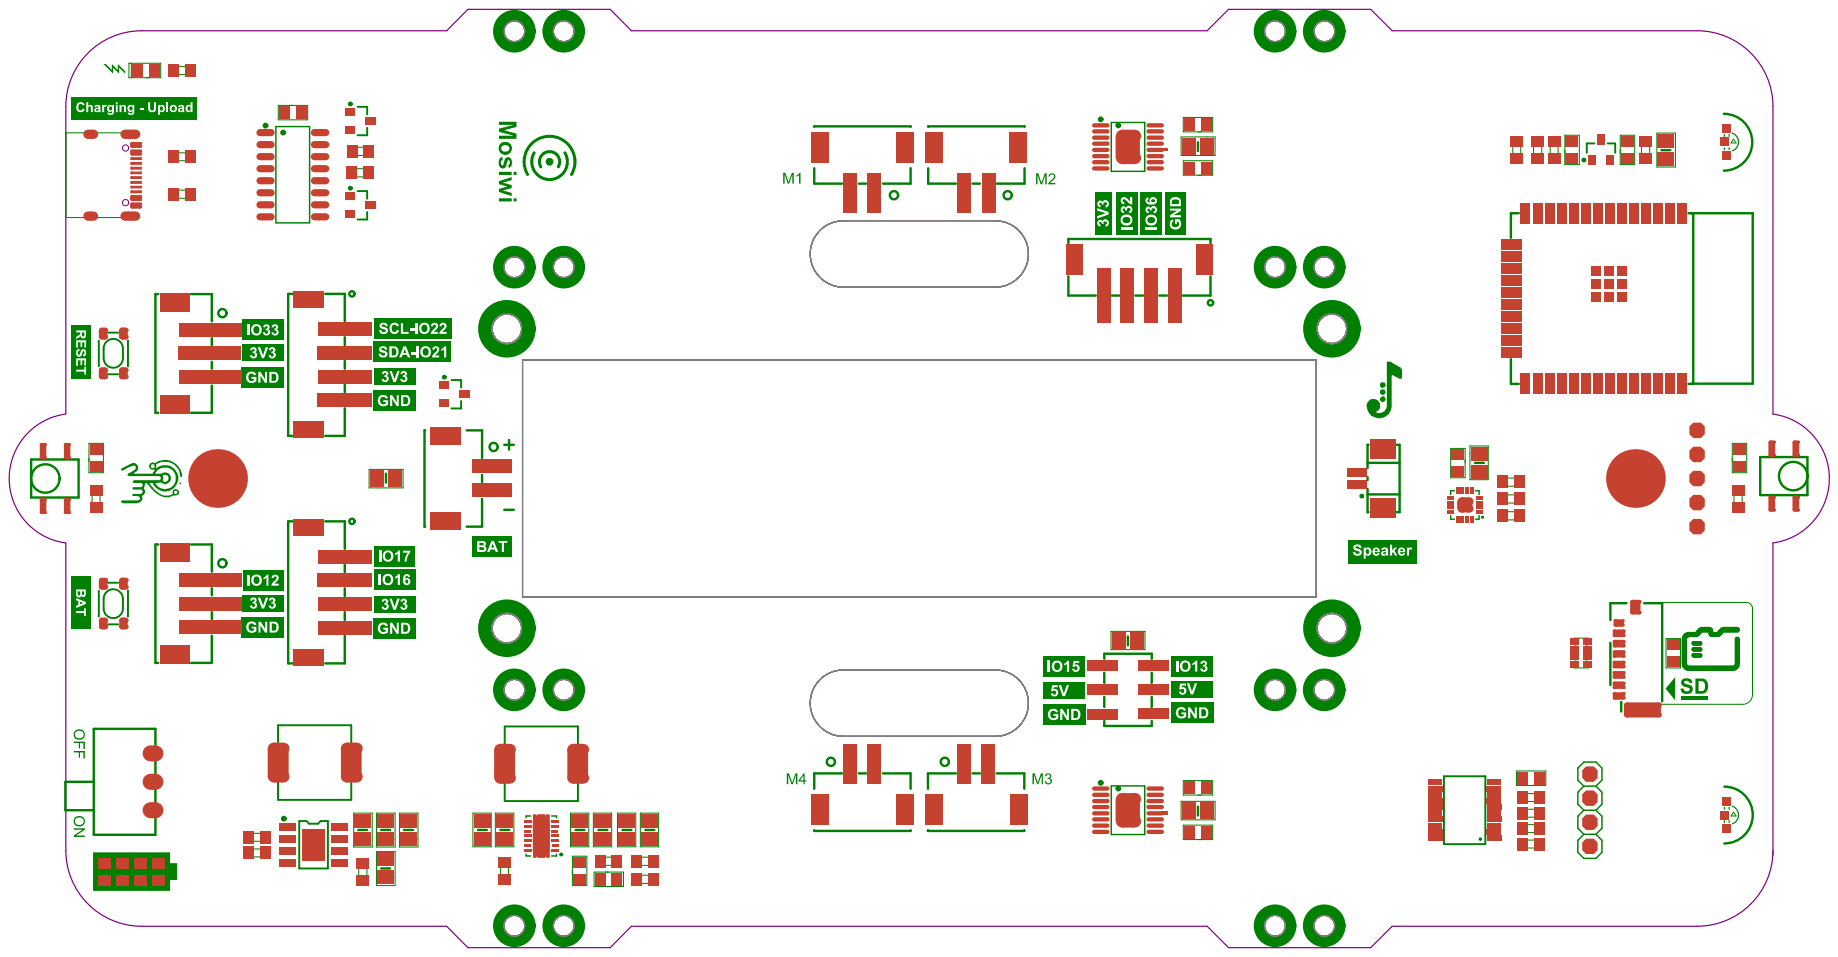
[picture p128: page 1]
