Mosiwi/E1K0000_eCar_kit/docs/source/_static/pdf/eCar_sch.PDF

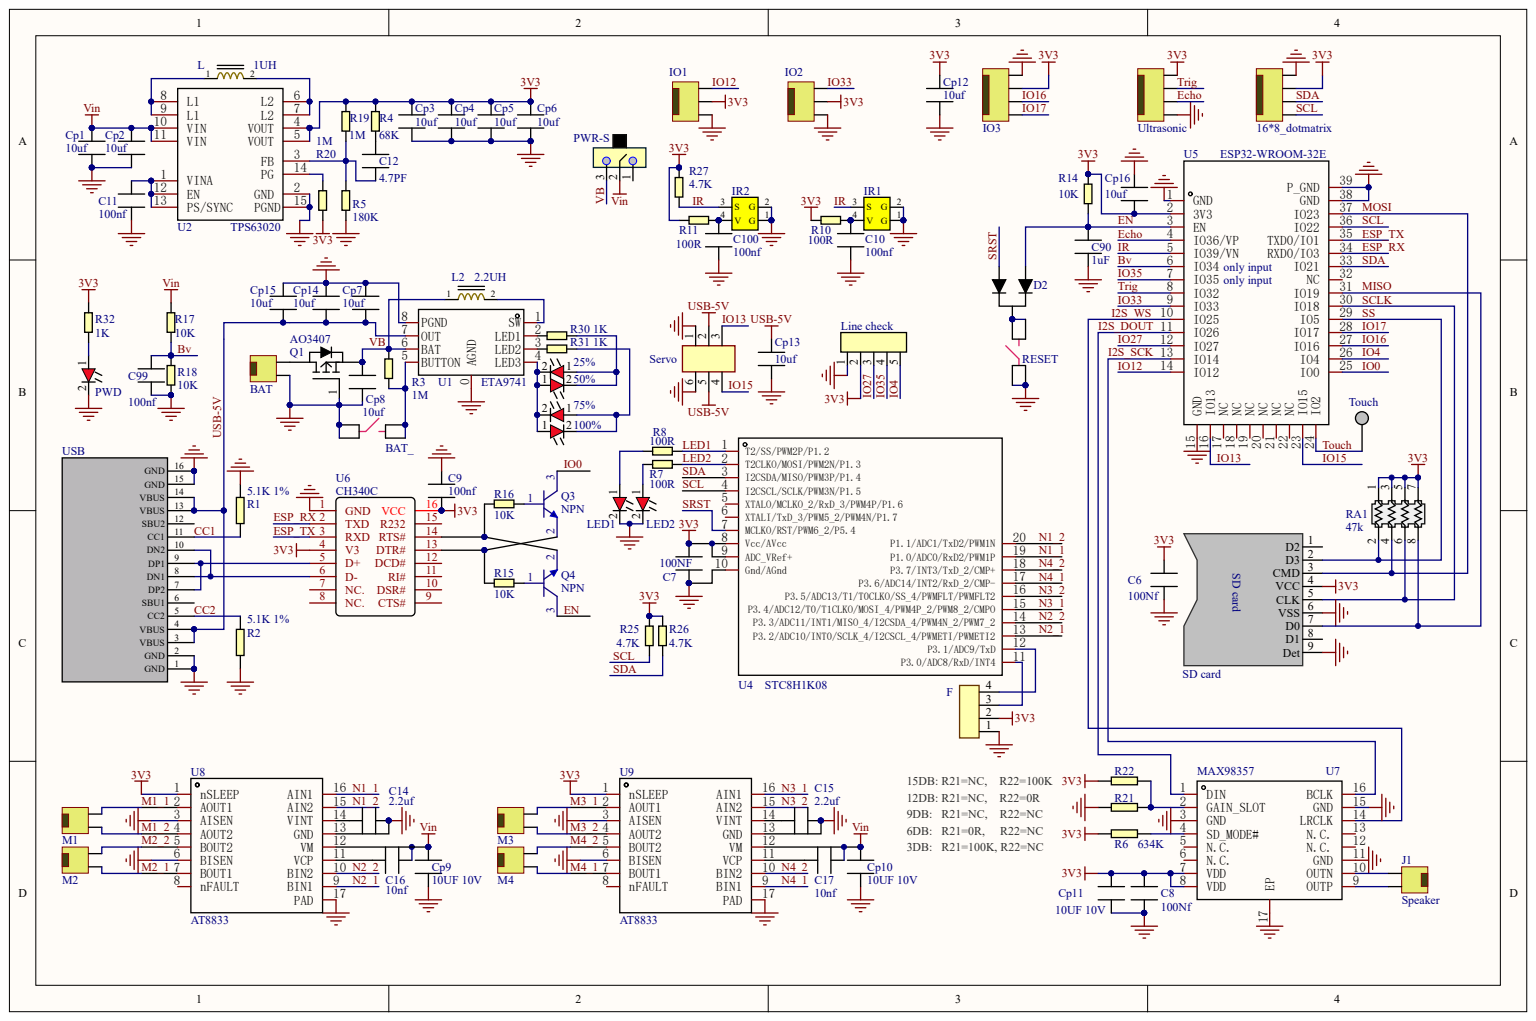
[picture p127: page 1]

IO2 24 IO15 23 NC 22 NC 21 NC 20 NC 19 NC 18 NC 17 IO13 16 GND 15 IO12 14 IO14 13 IO27 12 IO26 11 IO25 10 IO33 9 IO32 8 IO35 7 IO34 6 IO39/VN 5 IO36/VP 4 EN 3 3V3 2 GND 1

LED3 4 BUTTON 5 BAT 6 OUT 7 PGND 8
